Senekw/flextome/paper/flextome_paper.tex

\documentclass[11pt,a4paper]{article}
\usepackage[margin=2.2cm]{geometry}
\usepackage{lmodern}
\usepackage{graphicx}
\usepackage{booktabs}
\usepackage{amsmath}
\usepackage{siunitx}
\usepackage{microtype}
\usepackage[hidelinks]{hyperref}
\usepackage[numbers,sort&compress]{natbib}
\usepackage{caption}
\usepackage{enumitem}
\usepackage{placeins}
\renewcommand{\topfraction}{0.9}\renewcommand{\bottomfraction}{0.7}\renewcommand{\textfraction}{0.08}\renewcommand{\floatpagefraction}{0.75}
\setcounter{topnumber}{3}\setcounter{totalnumber}{5}
\usepackage{tabularx}
\usepackage{wasysym}
\captionsetup{font=small,labelfont=bf}
\sisetup{per-mode=symbol,range-phrase=--,range-units=single}
\DeclareSIUnit\rev{rev}
\graphicspath{{./figures/}}

\title{\textbf{FlexTome: a 3D-printed, flexure-pivot rocking microtome with a differential-screw feed for \SI{5}{\micro\metre} paraffin histology at a US\$61.97 bill of materials}}
\author{Design report: Engineering Mechanics / Biomedical Engineering}
\date{}

\begin{document}
\maketitle

\begin{abstract}
Histopathology is the reference standard for cancer diagnosis, but much of sub-Saharan Africa has roughly one pathologist per million people and district hospitals lack the US\$150\,000--200\,000 of equipment an essential pathology laboratory requires. The microtome that cuts 3--\SI{5}{\micro\metre} paraffin sections is one of the few items in that chain with no low-cost substitute: new manual rotary microtomes list at US\$9\,000--22\,700, and the thinnest published open-source sectioning device cuts at $\geq$\SI{50}{\micro\metre}, an order of magnitude too thick for diagnostic H\&E. We present FlexTome, a rocking-arm microtome designed to be printed on a \SI{235}{\milli\metre} desktop FDM printer and completed with hardware-store fasteners. Three design decisions make \SI{5}{\micro\metre} sectioning plausible from printed plastic: (i)~the arm pivot is a cross-strip flexure built from three \SI{0.20}{\milli\metre} spring-steel feeler-gauge strips, so the metrology loop contains no sliding or rolling joint and therefore no backlash; (ii)~the \SI{5}{\micro\metre} feed is generated by a differential screw (M8$\times$1.25 against M8$\times$1.0, \SI{0.25}{\milli\metre} per revolution) indexed by a 50-tooth printed ratchet that the arm itself advances at the top of each stroke, so the micrometre-scale motion is carried entirely by steel threads while the printed parts need only millimetre tolerances; and (iii)~the disposable blade rides on a monolithic printed parallelogram flexure stage preloaded against the screw. A crank-rocker drive gives a \SI{54}{\milli\metre} arc stroke at $\pm$\ang{12.5}. An analytic structural-loop model, calibrated by plane-stress finite-element models of the flexure stage, of the frame-nut upstand and of the frame, predicts a feed-axis loop stiffness of \SI{0.83}{\newton\per\micro\metre} (\SI{1.20}{\micro\metre\per\newton}). Two modelling lessons shaped the design: the frame model caught a \SI{0.83}{\micro\metre\per\newton} tower compliance that a beam model had missed and drove a gusset revision that cut it to \SI{0.21}{\micro\metre\per\newton}; and an external review of the first release showed that its feed-screw upstand, blade clamp and coupler did not form the load path the budget assumed (the upstand alone was \SI{7.3}{\micro\metre\per\newton}), which led to the connected, gusseted revision analysed here. A Monte-Carlo budget that treats every error as a stroke-to-stroke difference, with correlated thread-lead error, cutting-force variation, printed-ratchet error, pawl seating and thermal drift, predicts a section thickness of $5.0\pm0.7$\,\si{\micro\metre} (1~s.d.; 90\,\% interval 3.8--\SI{6.2}{\micro\metre}) at the \SI{5}{\micro\metre} setting with a thread-lead bias within $\pm0.7\,\%$, comparable to the $>\pm10\,\%$ deviation measured on commercial rotary microtomes in a 154-site survey. All structural resonances ($\geq$\SI{357}{\hertz}) lie far above the $<$\SI{9}{\hertz} cutting excitation, so chatter is not predicted. The bill of materials is US\$61.97, a $>99\,\%$ reduction relative to new list price. These are model predictions: the machine has not yet been built or measured. The design, analysis code and a validation protocol are released so that the predictions can be tested on a physical build.
\end{abstract}

\section{Introduction}
\subsection{The problem}
The cancer-diagnosis chain in low- and middle-income countries (LMICs) fails at the laboratory before it fails at the clinic. A 2016 survey of African pathology resources found population-per-pathologist ratios from 84\,000 (Mauritius) to 9.3~million (Niger), against 15\,000--20\,000 in the UK and US~\citep{Nelson2016}; the Lancet Commission on diagnostics estimates that 47\,\% of the world's population has little or no access to diagnostics~\citep{Fleming2021}; and an essential district-hospital pathology package costs US\$150\,000--200\,000 in equipment~\citep{Fleming2016}. Within that package, the microtome is the only instrument that converts a fixed, paraffin-embedded biopsy into the 3--\SI{5}{\micro\metre} section a pathologist can read. New manual rotary microtomes list at US\$22\,690 (Leica RM2125 RTS), US\$21\,548 (Sakura Accu-Cut SRM~200) and US\$8\,995 (Thermo HM~325); used units sell for US\$2\,100--7\,950 (vendor prices, October 2026).

\subsection{Why no low-cost microtome exists}
Open-source hardware has reached the microscope: the OpenFlexure microscope is printed for US\$20--200 and has been manufactured locally in Tanzania and Kenya~\citep{Collins2020}. It has not reached the microtome. The published low-cost sectioning devices cut at $\geq$\SI{50}{\micro\metre} (a hair-clipper vibrating razor~\citep{Bazer1980}), $<$\SI{100}{\micro\metre} for hand-fed plant tissue (Rapid-Tome~\citep{Thomas2023}) and \SI{250}{\micro\metre}--\SI{1}{\milli\metre} for live organoids (a US\$853 HardwareX slicer~\citep{MartinezMartin2024}). None embeds in paraffin, none uses a standard disposable microtome blade, and none has a micrometre-resolution feed. The barrier is mechanical: a \SI{5}{\micro\metre} section demands that the knife-to-specimen distance repeat to better than $\sim$\SI{1}{\micro\metre} stroke after stroke, while printed plastic parts have $\pm$0.1--\SI{0.2}{\milli\metre} dimensional scatter~\citep{Melenka2015}, creep under sustained load~\citep{Waseem2020}, a Young's modulus 60 times lower than steel~\citep{Tymrak2014}, and sliding joints printed in plastic have backlash of tens of micrometres.

\subsection{The design thesis}
Our thesis is that these limitations can be designed around rather than overcome, using three principles from precision-instrument design:
\begin{enumerate}[nosep]
\item \textbf{No sliding joints in the metrology loop.} Every joint between the blade edge and the specimen face that must repeat to $<$\SI{1}{\micro\metre} is a flexure: the arm pivot is a cross-strip flexure, the blade stage is a parallelogram flexure, and the screw-to-stage interface is a preloaded nut. Flexures have zero backlash and no stick-slip~\citep{Smith2000,Wittrick1948}.
\item \textbf{Keep the micrometre chain in steel.} The feed increment (\SI{5}{\micro\metre}) is set by the pitch difference of two standard steel threads and the tooth count of a ratchet; the printed parts only hold those steel parts in roughly the right place. The differential screw turns a \SI{0.25}{\milli\metre} pitch difference into fine motion without a precision thread~\citep{SmithChetwynd2017}.
\item \textbf{Make the structural loop short and deep.} Section-to-section thickness variation equals loop compliance $\times$ cutting-force variation; chatter is a stiffness phenomenon~\citep{Bayley1955,Warshawsky1983}. The loop is a one-piece ribbed base and a gusseted tower whose root depth (\SI{60}{\milli\metre}) was set by finite-element analysis.
\end{enumerate}
The rocking-arm kinematics themselves are not new: Horace Darwin's 1885 Cambridge rocker used a pivoted arm, screw feed and ratchet, and a modified rocker later cut sections for electron microscopy~\citep{Eaves1954}. What is new is the realisation of that kinematic in printed plastic and commodity steel at a US\$61.97 bill of materials, with an explicit, FE-checked stiffness and error budget.

\FloatBarrier
\section{Design}
\subsection{Architecture}
Figure~\ref{fig:concept} shows the assembly. The coordinate frame has $x$ along the feed (specimen~$\rightarrow$~blade), $y$ along the blade edge and $z$ vertical. Table~\ref{tab:subsystems} summarises the subsystems.

\begin{figure}[!htbp]\centering

\caption{FlexTome assembly with numbered components (frame footprint $235\times150$\,mm; overall envelope $272\times210\times202$\,mm including handwheel, feed knob and pawl rod). The specimen in a standard histology cassette (5) is carried on a \SI{125}{\milli\metre} printed arm (3) that rocks $\pm$\ang{12.5} on a cross-strip steel flexure pivot (2). The blade (6) sits on a parallelogram flexure stage (8) driven along $x$ by a differential screw (11); a striker bar on the arm (16) lifts a pawl rod (15) at the top of each stroke, advancing the 50-tooth ratchet drum (12) by 1--6 teeth (5--\SI{30}{\micro\metre}) as set by the selector shield (13). A crank-rocker (17, 18) with 608 bearings and a \SI{110}{\milli\metre} handwheel (19) drives the arm. Rendered from the parametric CAD model; Sec.~\ref{sec:mech} walks through each subsystem.}
\label{fig:concept}
\end{figure}

\begin{table}[!htbp]\small\centering
\caption{Subsystems and their role in the error budget.}
\label{tab:subsystems}
\begin{tabularx}{\linewidth}{@{}p{2.3cm}XX@{}}
\toprule
Subsystem & Implementation & Role in the error budget \\
\midrule
Frame & One printed part: $235\times150\times55$\,mm ribbed base, \SI{118}{\milli\metre} tower with a forward gusset (\SI{60}{\milli\metre} root depth tapering to \SI{32}{\milli\metre} at the pivot head), raised front deck; two M8 steel tie rods through the base & Closes the structural loop (\SI{0.21}{\micro\metre\per\newton} pivot-to-deck by FE with the base in full contact, \SI{0.35}{\micro\metre\per\newton} on two end pads; the latter is used); tie rods pre-compress the print against creep/warp and allow a split base for small printers \\
Arm pivot & Cross-strip flexure: three strips (10/20/10\,mm wide) of \SI{0.20}{\milli\metre} feeler-gauge steel, \SI{20}{\milli\metre} free length, crossing at mid-length, clamped in printed pads with M3 screws & Zero backlash; axially stiff (\SI{40}{\newton\per\micro\metre}); rotational stiffness \SI{0.27}{\newton\metre\per\radian} \\
Arm & Tapered hollow box beam $40\rightarrow30$\,mm, \SI{125}{\milli\metre} pivot-to-face; integral cassette clamp (fixed lower lip, sliding jaw, M5 thumbscrew) & Loaded axially during the cut; \SI{0.08}{\micro\metre\per\newton} \\
Drive & Crank radius \SI{13}{\milli\metre} at \SI{60}{\milli\metre} from pivot, crank centre \SI{71.2}{\milli\metre} below the arm joint; \SI{71.2}{\milli\metre} fork connecting rod running between two printed crank webs; built-up crankshaft of two \SI{8}{\milli\metre} stubs in two 608 bearings; \SI{110}{\milli\metre} spoked handwheel & Kinematics only; not in the metrology loop \\
Blade stage & Monolithic printed parallelogram: two $1.0\times44$\,mm plates (60\,mm and $2\times20$\,mm wide), platform, hanging nut tab; bolted to deck through slots ($\pm$\SI{10}{\milli\metre} coarse approach) & Guides the blade along $x$ with no sliding; pitch stiffness carries the cutting moment \\
Blade holder & Disposable low-profile blade ($80\times8\times0.25$\,mm) leaning back \ang{27} from vertical, its rear face bearing on a full-width printed back wall; \SI{1.0}{\milli\metre} steel clamp strip in front, pulled onto a \SI{0.20}{\milli\metre} blade recess by two M4 screws below the blade; \SI{2.5}{\milli\metre} edge overhang & The cutting force pushes the blade onto the back wall (not onto screw tips); clearance \ang{9.5} nominal; overhang compliance \SI{0.25}{\micro\metre\per\newton} \\
Fine feed & Differential screw: M8$\times$1.0 bolt in the stage-tab nut; its hex head sits in a printed coupler whose captured nut carries the M8$\times$1.25 rod, screwed in until the rod end bears on the bolt head (steel-on-steel axial path); the rod runs in the frame nut of a gusseted upstand $\rightarrow$ \SI{0.25}{\milli\metre\per\rev} stage motion while the screw itself translates \SI{1.25}{\milli\metre\per\rev}; both nuts sit on \SI{16}{\milli\metre} steel washers; two extension springs preload the tab onto one thread flank over the whole travel; \SI{14}{\milli\metre} long 50-tooth ratchet drum keeps the pawl engaged over the $\pm$\SI{5}{\milli\metre} screw travel; sector shield on the column selects 1--6 teeth; stage travel $\pm$\SI{1}{\milli\metre} (400 sections at \SI{5}{\micro\metre}) per reset & Sets the increment; thread-lead scatter \SI{0.18}{\micro\metre} (1~s.d.) and bias within $\pm0.7\,\%$; upstand \SI{0.19}{\micro\metre\per\newton} (FE) \\
Feed actuation & Vertical pawl rod in a printed guide, lifted $\leq$\SI{22}{\milli\metre} by a striker bar fixed to the arm during the last $\sim$\ang{6} of the upstroke; gravity/spring return & Feed occurs early in the down-stroke, when the striker releases the rod at $\theta\approx$\ang{6}, before the face reaches the edge \\
\bottomrule
\end{tabularx}
\end{table}

\subsection{Kinematics}
The crank-rocker (Fig.~\ref{fig:kin}a,b; Sec.~\ref{sec:mech}) gives $\theta=\pm$\ang{12.5}, a block-face stroke of \SI{54}{\milli\metre} and one section per handwheel turn. The machine is hand-driven, so the cutting speed is whatever rate the operator turns the wheel; all speed-dependent figures in this paper are quoted at a reference rate of 60~rpm (one section per second, the pace commonly used on manual rotary microtomes), at which the face crosses the edge at 153--\SI{174}{\milli\metre\per\second}. This is a reference point, not a measured operating speed, and the validation plan (Sec.~\ref{sec:validation}) treats speed as a variable to be set and recorded. Because the specimen travels on an arc, the face retracts \SI{3.0}{\milli\metre} from the blade at the stroke ends and the cut face is a cylinder of radius \SI{125}{\milli\metre} (sagitta \SI{0.40}{\milli\metre} over a \SI{20}{\milli\metre} block). The latter is the rocker's classical ``curved section'' property; because every stroke follows the identical arc, the curvature is cut into the block face once and the next section (the difference between two successive arcs) has uniform thickness. The effective clearance angle varies by $\pm$\ang{4.6} across a \SI{20}{\milli\metre} face; a \ang{27} blade lean (clearance \ang{9.5} at mid-face, rake \ang{45.5} with a \ang{35} blade facet) keeps it within 4.9--\ang{14.1}, inside the 3--\ang{15} range practitioners recommend (Fig.~\ref{fig:kin}c).

\begin{figure}[!htbp]\centering
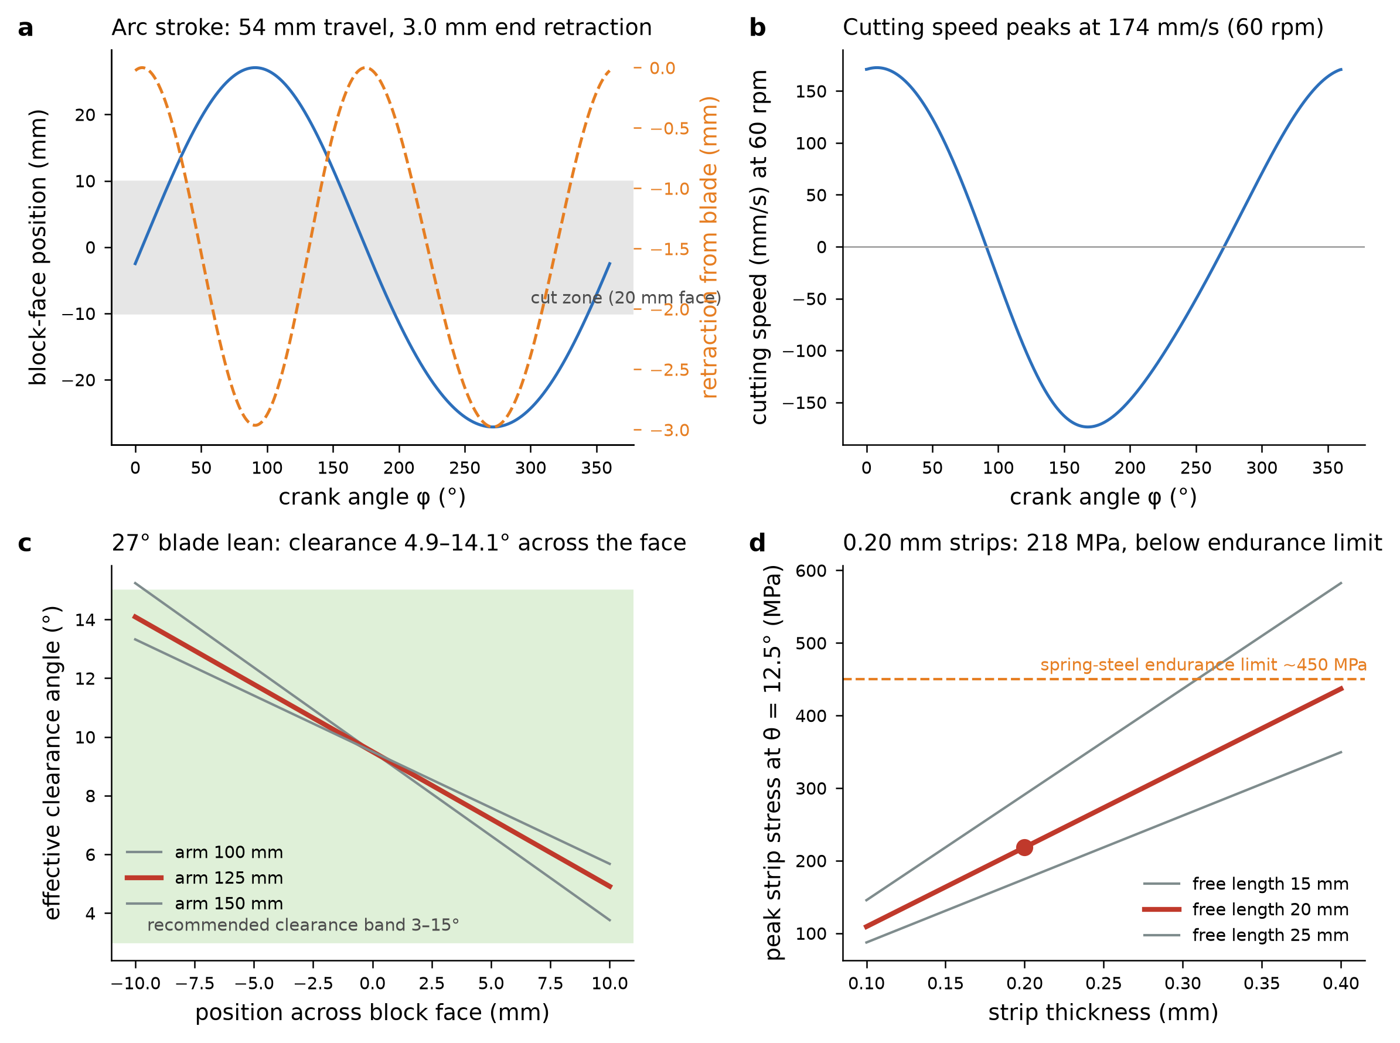
[picture p4: paper/figures/fig2_kinematics_pivot.png]

\caption{Kinematics and pivot. (a)~Face position and retraction vs crank angle. (b)~Cutting speed. (c)~Effective clearance angle across the face for three arm lengths. (d)~Peak pivot-strip bending stress vs strip thickness; the chosen $0.20\times20$\,mm strips reach \SI{218}{\mega\pascal} at full swing, below the $\sim$\SI{450}{\mega\pascal} endurance limit of hardened spring steel (feeler-gauge stock; the exact limit must be taken from the stock datasheet). Rotational stiffness is \SI{0.267}{\newton\metre\per\radian} (torque \SI{0.058}{\newton\metre} at full swing); the second-order centre shift is $\approx0.1\,L\theta^2\approx$\SI{95}{\micro\metre} at $\pm$\ang{12.5}, which is repeatable and therefore shapes the arc rather than the thickness~\citep{Wittrick1948,Haringx1949}.}
\label{fig:kin}
\end{figure}

\subsection{Feed resolution}
With pitches $p_1=\SI{1.25}{\milli\metre}$ and $p_2=\SI{1.00}{\milli\metre}$, one revolution advances the stage by $p_1-p_2=\SI{0.25}{\milli\metre}$ toward the specimen; one tooth of the 50-tooth ratchet is \SI{5.0}{\micro\metre}. The selector shield exposes $k=1\ldots6$ teeth to the pawl, giving 5, 10, 15, 20, 25 or \SI{30}{\micro\metre} settings (trimming at 20--\SI{30}{\micro\metre}, sectioning at \SI{5}{\micro\metre}). Only the \emph{difference} of the two threads matters, so ordinary rolled-thread hardware is sufficient: the budget assumes 1\,\% independent local pitch error on each thread and \SI{3}{\micro\metre} peak-to-peak periodic error per revolution.

\subsection{Blade stage design}
Figure~\ref{fig:stage}a maps plate thickness and height against bending stress at the $\pm$\SI{1}{\milli\metre} feed travel and against the $x$-stiffness that sets the preload. The chosen $1.0\times44$\,mm plates give $k_x=\SI{4.9}{\newton\per\milli\metre}$ (analytic) / \SI{4.0}{\newton\per\milli\metre} (FE), $\leq$\SI{5}{\newton} preload on the screw, \SI{5.4}{\mega\pascal} peak plate stress and a creep safety factor of 2.8 against a \SI{15}{\mega\pascal} sustained-stress limit for PLA~\citep{Waseem2020}; PETG or ASA are drop-in alternatives. In the screw-held condition the stage is a short cantilever about the tab nut; with the gusseted tab of revision~2 the FE model (Fig.~\ref{fig:feastage}) gives \SI{0.132}{\micro\metre\per\newton} at the blade edge, and this value is used in the budget. Because a symmetric parallelogram is neutral at mid-travel, its own restoring force would reverse direction across the $\pm$\SI{1}{\milli\metre} range and let the nut change thread flank; two light extension springs ($\sim$\SI{10}{\newton} total) between the tab and the upstand therefore keep the nut on the flank that the cutting force also loads.

A consequence of the differential principle that is easy to overlook: the screw body advances through the frame nut by the full \SI{1.25}{\milli\metre} per revolution while the stage moves \SI{0.25}{\milli\metre}, so over the $\pm$\SI{1}{\milli\metre} stage range the screw, coupler, ratchet and knob translate $\pm$\SI{5}{\milli\metre}. The ratchet is therefore a \SI{14}{\milli\metre} drum rather than a wheel, the \SI{13}{\milli\metre} coupler sits in a \SI{24}{\milli\metre} gap between the stage tab and the upstand, and the thickness-selector shield is mounted on the stage body, not on the screw. A boolean interference audit of the assembly (Sec.~\ref{sec:audit}) confirmed that no unintended contacts remain over the full stroke and screw travel.

\begin{figure}[!htbp]\centering
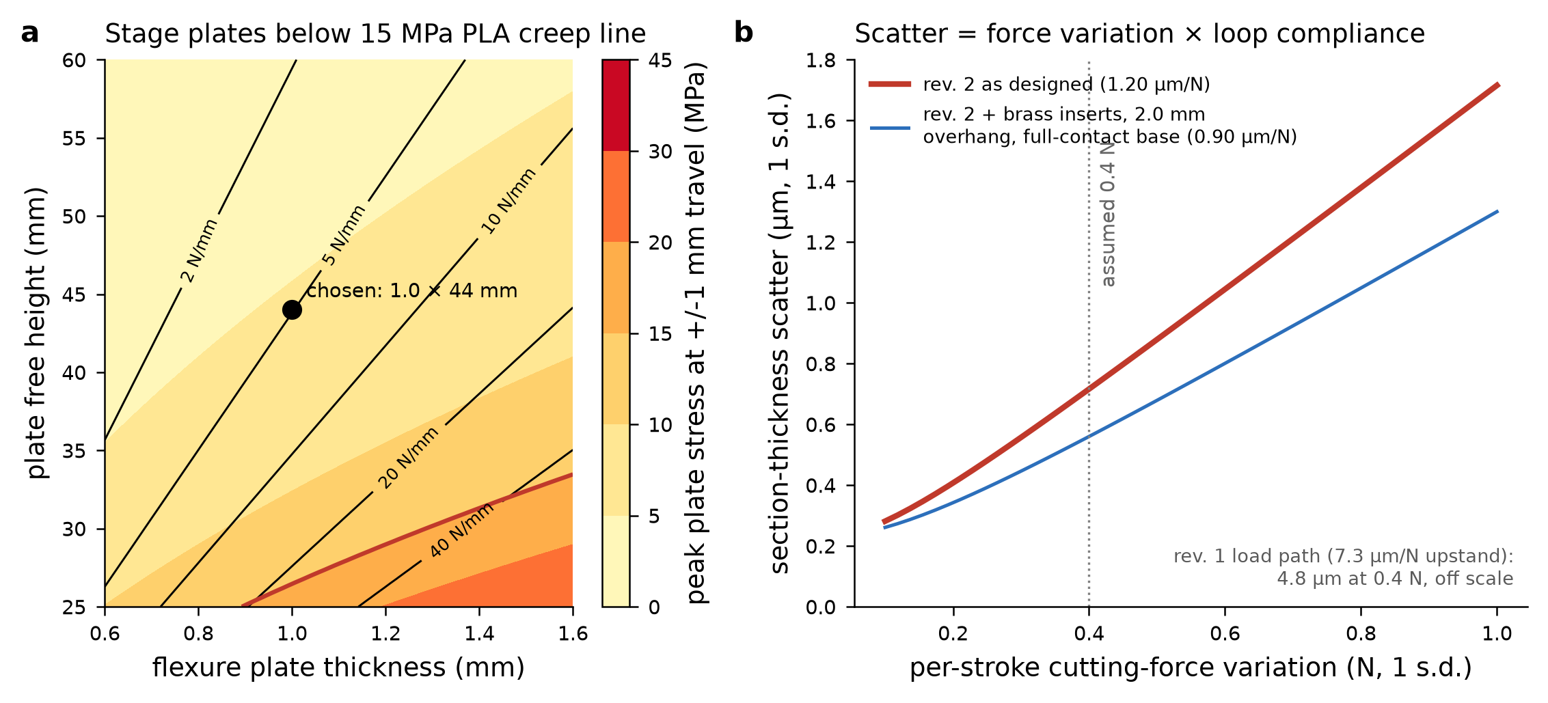
[picture p5: paper/figures/fig4_stage_design_map.png]

\caption{(a)~Design map of the flexure stage; the red contour is the \SI{15}{\mega\pascal} PLA creep line. (b)~Predicted thickness scatter vs cutting-force variation for the original slender tower and the gusseted tower; the gusset reduces scatter by $\sim$25\,\% at the assumed \SI{0.4}{\newton} force variation.}
\label{fig:stage}
\end{figure}

\begin{figure}[!htbp]\centering
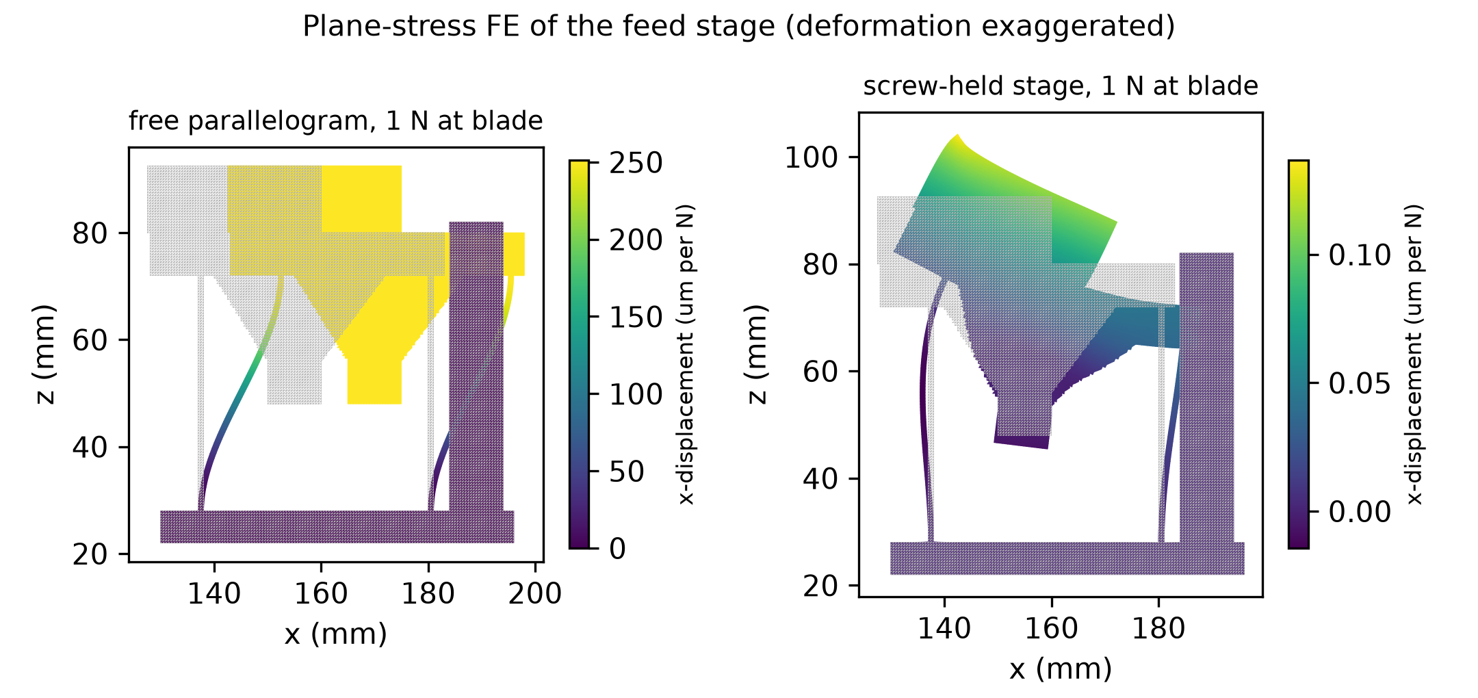
[picture p6: paper/figures/fig5_fea_stage.png]

\caption{Plane-stress finite-element model of the revision-2 stage (scikit-fem, quadratic triangles, 16\,882 elements; out-of-plane widths represented by scaling $E$ per region). Left: free stage under \SI{1}{\newton} at the blade, $k_x=\SI{3.98}{\newton\per\milli\metre}$. Right: stage held at the tab nut, compliance \SI{0.132}{\micro\metre\per\newton} at the blade.}
\label{fig:feastage}
\end{figure}

\subsection{Frame design: an FE-driven revision}
The beam model treated the tower as a $70\times70$\,mm box and the base as a plate rotating under the tower-root moment, and predicted that two M8 tie rods would triple base rigidity. A plane-stress FE model of the frame side-section (Fig.~\ref{fig:feaframe}) showed otherwise: with the tower as actually drawn (\SI{32}{\milli\metre} deep), pivot-to-deck compliance was \SI{0.83}{\micro\metre\per\newton}, essentially all tower bending, and the tie rods changed it by only 2\,\% because the ribbed base was already stiff. Adding a forward gusset (the tower root widened to \SI{60}{\milli\metre} over the first \SI{55}{\milli\metre} of height, tapering to the \SI{32}{\milli\metre} head, within the existing footprint and clear of the arm's swing) reduced the frame compliance to \SI{0.21}{\micro\metre\per\newton} with the whole underside bearing on the bench. Because a printed base may warp and bear only at its ends, the budget uses the two-end-pad support case, \SI{0.35}{\micro\metre\per\newton} (\SI{0.42}{\micro\metre\per\newton} without the tie rods, which do matter in that case). The tie rods were retained for a different reason: they pre-compress the printed base against creep and warp and allow the base to be printed in two halves on small printers.

\begin{figure}[!htbp]\centering
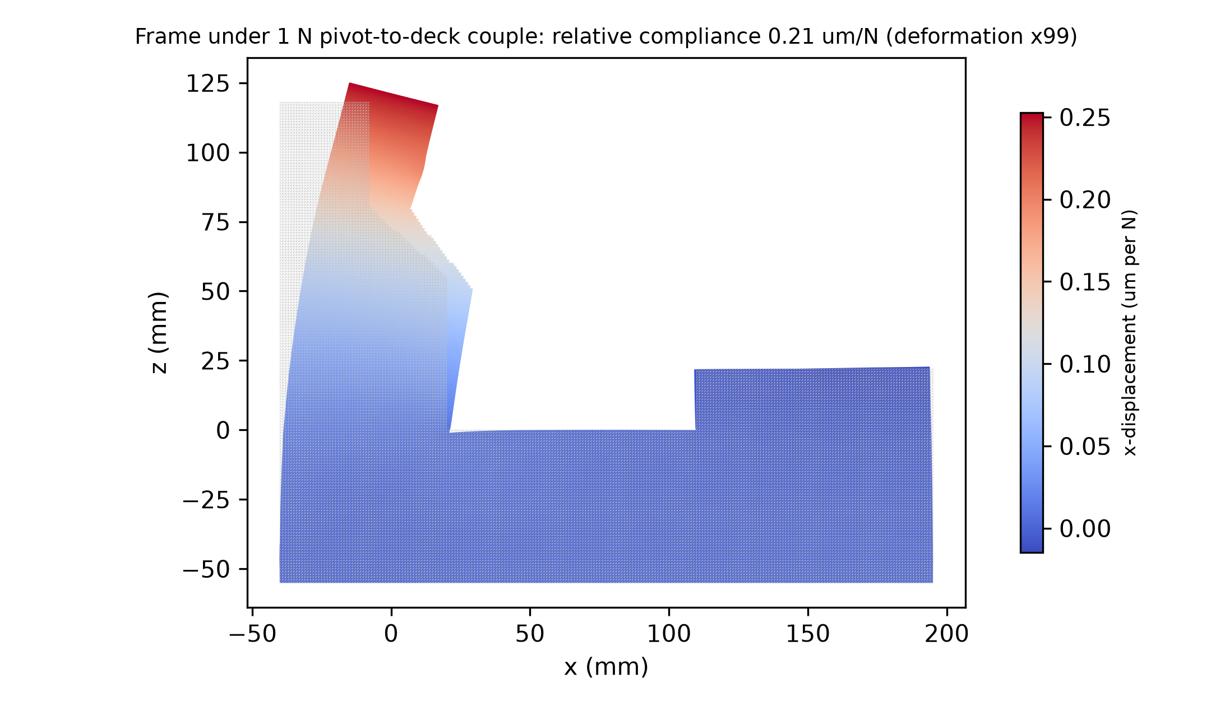
[picture p7: paper/figures/fig6_fea_frame.png]

\caption{Plane-stress FE of the gusseted frame under a self-equilibrated \SI{1}{\newton} couple between the pivot and the stage-foot clamp zone (quadratic triangles, 42\,281 elements; ribbed base represented by a 40\,\% web fraction with solid \SI{6}{\milli\metre} skins). Relative pivot-to-deck compliance \SI{0.21}{\micro\metre\per\newton} (full-contact base; \SI{0.35}{\micro\metre\per\newton} on two end pads), versus \SI{0.83}{\micro\metre\per\newton} for the original slender tower.}
\label{fig:feaframe}
\end{figure}

\input{mechanism_section}

\FloatBarrier
\subsection{Load-path corrections after external review (revision 2)}
\label{sec:rev2}
The first release of this design was reviewed independently against its own CAD and code. The review found that the structural-loop budget did not describe the load path the CAD actually contained, and the design and model were revised accordingly. The findings and corrections are listed here because they changed the headline numbers (Table~\ref{tab:rev2}).

\begin{table}[!htbp]\small\centering
\caption{External-review findings on revision 1 and the revision-2 response.}
\label{tab:rev2}
\begin{tabularx}{\linewidth}{@{}p{3.6cm}XX@{}}
\toprule
Finding (revision 1) & Why it mattered & Revision 2 \\
\midrule
Frame-nut upstand not connected to the stage foot (2\,mm gap) and only $6\times32$\,mm; omitted from the budget & A \SI{7.3}{\micro\metre\per\newton} cantilever in series with everything else: the loop would have been $\approx$\SI{8.5}{\micro\metre\per\newton} and the scatter $\approx$\SI{4.8}{\micro\metre} & Upstand continuous with the foot, \SI{10}{\milli\metre} wall, \SI{64}{\milli\metre} wide, central and side gussets: \SI{0.185}{\micro\metre\per\newton} by FE (Sec.~\ref{sec:fe}) \\
Blade held between a front pressure strip and two rear grub-screw tips & The cutting force pushes the blade \emph{away} from the strip, onto two screw points; the budget's full-width compression term did not represent this & Full-width printed back wall behind the blade carries the force; the strip clamps the blade onto a \SI{0.20}{\milli\metre} recess with two M4 screws below the blade \\
Coupler \SI{0.7}{\milli\metre} thick behind the bolt head; coarse rod not engaged with it & Unsubstantiated strength and stiffness of the only link between the two threads & \SI{13}{\milli\metre} coupler with a captured M8$\times$1.25 nut; the rod is screwed in until its end bears on the bolt head, so the axial path is steel on steel \\
Budget contained a \SI{6}{\milli\metre} ball contact that exists nowhere in the CAD; only one nut-bedding term & Fictitious and missing terms & Ball term removed; tab-nut and frame-nut bedding both included, on steel washers; coupler contact added \\
Flexure preload reverses across mid-travel & Nut could change thread flank mid-ribbon & Two extension springs preload the tab in the direction of the cutting force \\
Cutting-force variation applied as $C\,F_i$ & Thickness depends on $F_i-F_{i-1}$: the force term was $\sqrt2$ too small & Monte-Carlo rewritten so every error enters as a stroke-to-stroke difference \\
Thread pitch redrawn independently every stroke & Real lead error is fixed along the screw and correlated step to step; it produces bias as well as scatter & Lead error modelled as cumulative + periodic + local random walk per simulated screw pair; bias reported separately \\
Frame FE supported along its whole underside & A warped print bears on its ends & Two-end-pad case computed and adopted \\
Disconnected mesh shells (stage, selector strap), missing M3 holes, sealed arm cavity; audit script absent & Unprintable or unassemblable as exported; audit not reproducible & All 35 STLs now single connected shells (checked in \texttt{audit\_interference.py}, which is in the repository); insert holes added; arm cavity vented \\
No scripts for the modal, transient, fracture and BOM numbers & Not reproducible & \texttt{extra\_analysis.py} and \texttt{make\_bom.py} added \\
\bottomrule
\end{tabularx}
\end{table}

The revision lowered the deck by \SI{8}{\milli\metre} (to $z=22$\,mm) so that the taller blade holder fits above the platform while the flexure plates keep their \SI{44}{\milli\metre} free height, lowered the screw axis to $z=60$\,mm, and shifted the drum, shield and knob \SI{3}{\milli\metre} outward to clear the thicker upstand. With the connected load path the loop compliance is \SI{1.20}{\micro\metre\per\newton}; had revision~1 been built as drawn, the model predicts it would have cut $5\pm4.8$\,\si{\micro\metre}.

\FloatBarrier
\section{Analysis methods}
\paragraph{Structural-loop model.} Each element between the blade edge and the specimen face was assigned a compliance along $x$ under a unit cutting force: blade overhang bending and bearing on the back wall, the FE-calibrated stage (pitch about the tab nut), tab-nut bedding, the screw column and the rod-on-bolt-head contact, frame-nut bedding, the FE-calibrated upstand, the FE-calibrated frame (tower + base), the pivot strips in tension, the arm in compression, and the cassette clamp. Nut bedding on a \SI{16}{\milli\metre} steel washer is taken as \SI{1.5e7}{\newton\per\metre} (\SI{0.5e7}{\newton\per\metre} for a bare nut on PLA layer lines; both are allowances, not measurements). PLA $E=\SI{3.5}{\giga\pascal}$~\citep{Tymrak2014}, steel \SI{200}{\giga\pascal}.

\paragraph{Monte-Carlo thickness budget.} Section $i$ is the difference between the blade position during cut $i$ and during cut $i-1$, so every error source enters as a stroke-to-stroke difference. 200 screw pairs $\times$ 100 consecutive strokes were simulated with: a lead-error function fixed along each thread (cumulative error uniform within $\pm0.1\,\%$, per-revolution periodic error of 0.75--\SI{1.5}{\micro\metre} amplitude, and a local random walk of 0.3\,\% of pitch per step), evaluated where each nut sits at each stroke; ratchet tooth-pitch error of \SI{0.05}{\milli\metre} (1~s.d.) on the \SI{50}{\milli\metre} pitch circle; per-stroke cutting-force variation of \SI{0.4}{\newton} (1~s.d.), so that the force \emph{difference} between strokes has s.d.\ $\sqrt2\times0.4$\,N, acting through the loop compliance; thermal drift over the \SI{1}{\second} stroke interval at \SI{1}{\kelvin} per \SI{30}{\minute} room drift; and \SI{0.1}{\micro\metre} pawl seating. The cumulative lead term appears as a per-machine bias, reported separately from the scatter. The nominal cutting force (\SI{2}{\newton}) and its variation are assumptions (no absolute paraffin cutting-force measurement exists in the literature~\citep{Willis1995}), and Fig.~\ref{fig:stage}b shows the sensitivity.

\paragraph{Finite elements.}\label{sec:fe} 2-D plane-stress linear elasticity (scikit-fem, quadratic triangles) of the stage cross-section (load at the blade, foot and tab nut fixed), of the stage foot with the frame-nut upstand (load at the nut-pocket floor, foot bottom fixed; run for the revision-1 and revision-2 geometries) and of the frame side-section (self-equilibrated pivot-to-deck couple; underside fixed either fully or on two end pads), with out-of-plane widths represented by scaling $E$ per region. Verified against a cantilever benchmark (tip deflection \SI{97.3}{\milli\metre\per\newton} analytic vs 97.3 FE).

\paragraph{Modal estimates.} Lumped single-degree-of-freedom estimates for arm bending in the swing plane, stage $x$-motion and whole-loop $x$-motion.

\paragraph{Cost.} Printed-part cost from solid-modelled volume at US\$20/kg PLA (an upper bound; ribbed and infilled prints weigh less); hardware at typical online/hardware-store prices.

\FloatBarrier
\section{Results}
\subsection{Stiffness budget}
Total feed-axis compliance is \SI{1.20}{\micro\metre\per\newton} (stiffness \SI{0.83}{\newton\per\micro\metre}). The three largest terms are the frame on two end pads (\SI{0.35}{\micro\metre\per\newton}, FE), blade overhang (0.25) and the gusseted upstand (0.19, FE); the stage pitch is 0.13, the two nut seats 0.07 each, and the pivot strips only 0.02 (Fig.~\ref{fig:budget}a). With the revision-1 upstand and clamp as drawn the total would have been \SI{8.5}{\micro\metre\per\newton}.

\begin{figure}[!htbp]\centering
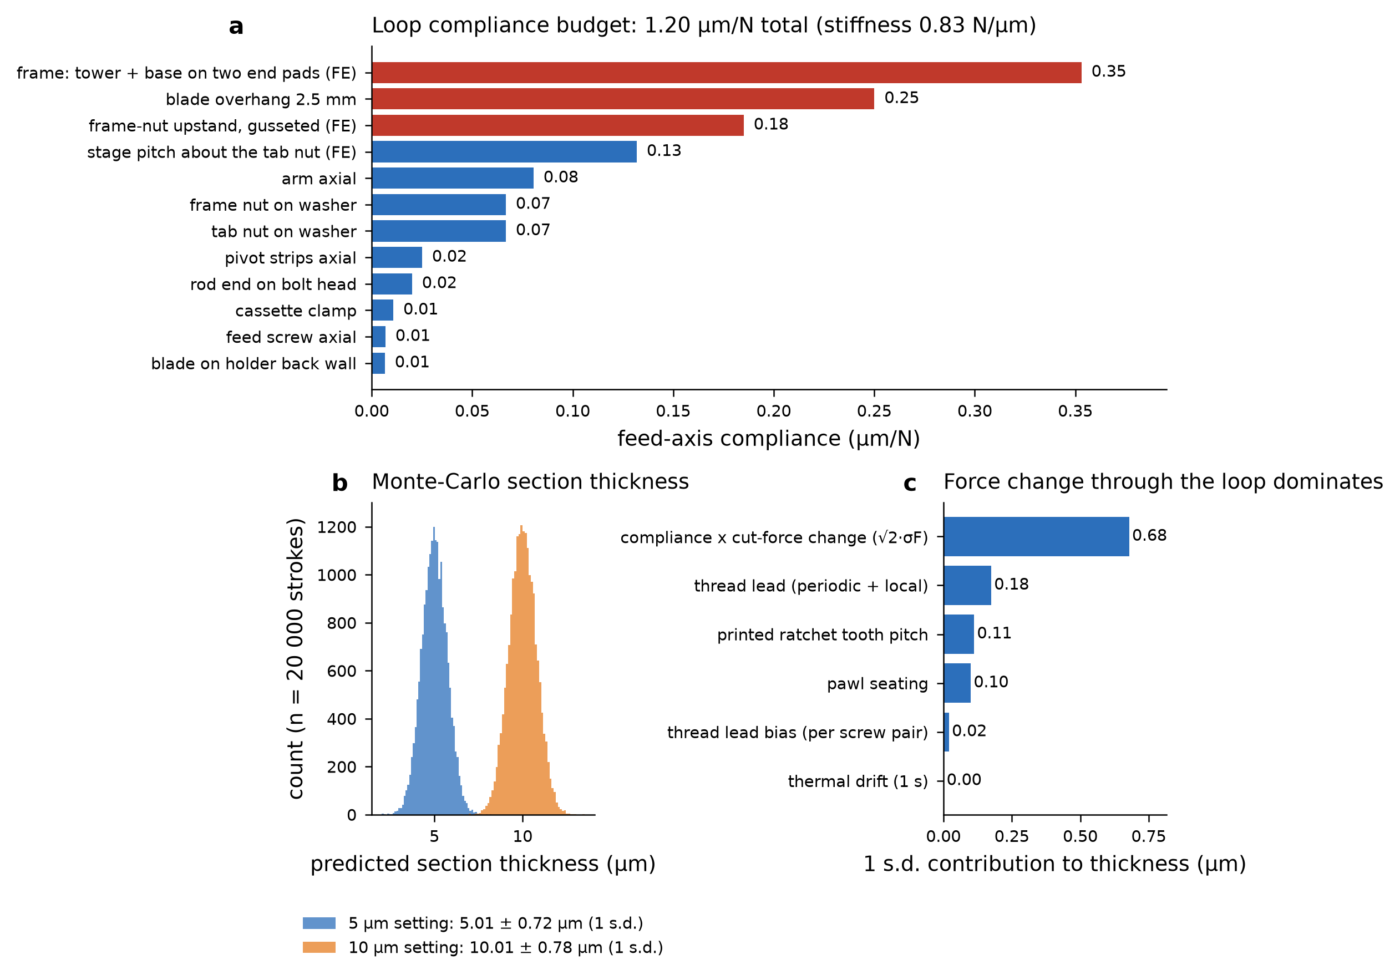
[picture p8: paper/figures/fig3_error_budget.png]

\caption{(a)~Compliance budget of the metrology loop. (b)~Monte-Carlo section thickness at the \SI{5}{\micro\metre} and \SI{10}{\micro\metre} settings ($n=20\,000$). (c)~1-s.d.\ contribution of each error source at the \SI{5}{\micro\metre} setting.}
\label{fig:budget}
\end{figure}

\subsection{Predicted section thickness}
At the \SI{5}{\micro\metre} setting the predicted section is $\mathbf{5.01\pm0.72}$\,\si{\micro\metre} (1~s.d.), 90\,\% interval 3.84--\SI{6.19}{\micro\metre}; at \SI{10}{\micro\metre}, $10.01\pm0.78$\,\si{\micro\metre}. The stroke-to-stroke change in cutting force acting through the loop compliance (\SI{0.68}{\micro\metre}) dominates; thread lead (\SI{0.18}{\micro\metre}), printed-ratchet error (0.11) and pawl seating (0.10) follow; thermal drift within a ribbon is negligible (Fig.~\ref{fig:budget}c). The cumulative lead error of the two threads adds a per-machine bias of $\pm0.7\,\%$ (90\,\% interval), which a one-time calibration against a measured ribbon removes. For context, direct measurement at 154 sites found more than two-thirds of sections from commercial rotary microtomes outside $\pm10\,\%$ of the dial setting~\citep{Fujisawa2026}; FlexTome's predicted 1-s.d.\ scatter is $\pm14\,\%$.

\subsection{Thermal behaviour}
The PLA loop expands \SI{10.6}{\micro\metre\per\kelvin}. This is irrelevant within a ribbon (strokes \SI{1}{\second} apart) but means the first sections after a temperature change or after mounting a new block will run thick or thin by several micrometres until trimmed, the same behaviour the Leica microtomy guide describes for a cold block, and handled by the same routine (trim, then section).

\subsection{Dynamics and chatter}
Estimated first modes: arm bending \SI{357}{\hertz}, whole-loop feed-axis \SI{459}{\hertz}, blade stage \SI{1.5}{\kilo\hertz}. A \SI{20}{\milli\metre} face is cut in \SI{118}{\milli\second}, so the cutting excitation is concentrated below $\sim$\SI{9}{\hertz}; no resonance-driven chatter is predicted. The rotational mode of the arm on its pivot ($\approx$\SI{4}{\hertz}) is the actuated degree of freedom and is constrained by the connecting rod.

\subsection{Cost and manufacturability}
\begin{table}[!htbp]\centering\small
\caption{Bill of materials (US\$).}
\begin{tabular}{@{}lr@{}}
\toprule
Category & Cost \\
\midrule
16 printed part types (20 pieces), \SI{1.40}{\litre} PLA (solid-modelled upper bound) & 34.57 \\
Hardware (feeler gauges, bearings, shaft, rods, nuts, washers, screws, springs) & 24.80 \\
Consumables (one blade, adhesive, grease) & 2.60 \\
\midrule
\textbf{Total} & \textbf{61.97} \\
\bottomrule
\end{tabular}
\end{table}
Against US\$8\,995--22\,690 new and US\$2\,100--7\,950 used, this is a $>99\,\%$ and $>97\,\%$ reduction respectively. The largest part (frame, $235\times150\times173$\,mm) fits an Ender-3-class \SI{235}{\milli\metre} bed (or is split at the deck step for smaller printers); all other parts fit a \SI{180}{\milli\metre} bed. No machining is required; the only cutting operations are shearing feeler-gauge strips to length and cutting threaded rod.

\subsection{Cutting-force bound, improvement levers and the entry transient}
\label{sec:levers}
Because no absolute paraffin cutting force has been published, the $2\pm0.4$\,\si{\newton} assumption was bracketed with the pressing-and-slicing fracture model~\citep{Atkins2004}: with a fracture work $R=20$--\SI{80}{\joule\per\metre\squared}, wax yield stress 1--\SI{3}{\mega\pascal}, a \ang{35} facet and friction coefficient 0.3, a $\SI{5}{\micro\metre}\times\SI{25}{\milli\metre}$ cut requires 0.6--\SI{2.4}{\newton} along the stroke and only 0.23--\SI{0.86}{\newton} along the feed axis ($\leq$\SI{1.3}{\newton} for a dulled blade with doubled friction). The feed-axis force that drives thickness error is therefore likely below the \SI{2}{\newton} assumed, and the \SI{0.4}{\newton} (1~s.d.) variation is conservative; at \SI{0.2}{\newton} the predicted scatter falls to \SI{0.41}{\micro\metre}.

Three levers remain. (i)~The blade overhang on the \emph{back-wall} side is not limited by the specimen's swept circle (that limit applies to the front strip, whose top would enter the circle by \SI{0.09}{\milli\metre} at \SI{2.0}{\milli\metre}), so the wall top can rise to \SI{2.0}{\milli\metre} below the edge with a relief chamfer for the section: $1.20\rightarrow$\SI{1.08}{\micro\metre\per\newton}, scatter $0.72\rightarrow$\SI{0.65}{\micro\metre}. (ii)~Bedding the base fully on the bench (or shimming its ends) recovers the full-contact frame value: $1.20\rightarrow$\SI{1.06}{\micro\metre\per\newton}, \SI{0.64}{\micro\metre}. (iii)~Brass inserts in place of washers under the two nuts: $1.20\rightarrow$\SI{1.17}{\micro\metre\per\newton}. All three together give \SI{0.90}{\micro\metre\per\newton} and \SI{0.56}{\micro\metre} (Fig.~\ref{fig:stage}b). Bare nuts on PLA, by contrast, would give \SI{1.47}{\micro\metre\per\newton} and \SI{0.86}{\micro\metre}.

Within a single section, the cutting force rises over the $\sim$\SI{0.5}{\milli\metre} entry chamfer of the block face in $\sim$\SI{3}{\milli\second}. Driving the \SI{459}{\hertz}, 3\,\%-damped loop with that ramp gives a 17\,\% dynamic overshoot (\SI{0.41}{\micro\metre} on a \SI{2.4}{\micro\metre} quasi-static deflection) that rings down within \SI{46}{\milli\second} of the \SI{118}{\milli\second} cut, bounding within-section thickness non-uniformity from this source to $\approx$\SI{0.4}{\micro\metre} over the first \SI{7}{\milli\metre} of the face.

\FloatBarrier
\section{Discussion}
\paragraph{What the analysis establishes.} The predicted $5.0\pm0.7$\,\si{\micro\metre} is a model result, not a measurement. Its value is that it identifies, quantitatively, what limits a printed microtome: not feed resolution (the steel differential screw delivers \SI{5}{\micro\metre} trivially) but loop stiffness against stroke-to-stroke cutting-force change, and within that, frame support, blade overhang and the frame-nut upstand. Two lessons about method stand out. The frame FE showed that a beam-theory budget built on an idealised tower section under-predicted tower compliance eight-fold and credited the tie rods with a stiffening they do not provide. The external review of revision~1 showed something more basic: a budget is only as good as its correspondence to the drawn load path, and the drawn load path had a \SI{7.3}{\micro\metre\per\newton} element the budget never contained. Checking that every element in the force path is a connected, fastened body in the CAD, and that every term in the budget is one of those bodies, is now part of the release checklist (Sec.~\ref{sec:rev2}).

\paragraph{Relation to prior art.} The Darwin rocker already combined arm, screw and ratchet; what it lacked was a bearing that a printed machine could reproduce. Replacing its hardened steel knife-edge or journal pivot with crossed feeler-gauge strips removes the one component that required a machine shop. The differential screw is a textbook element~\citep{SmithChetwynd2017} but has not previously been reported in a microtome, where it allows the \SI{5}{\micro\metre} increment to come from two hardware-store threads rather than a micrometer spindle. The parallelogram blade stage follows the OpenFlexure precedent that FDM compliant mechanisms achieve micron-scale repeatability~\citep{Sharkey2016}.

\paragraph{Limitations and risks.}
\begin{enumerate}[nosep]
\item \emph{Cutting force is assumed.} The $2\pm0.4$\,\si{\newton} figure is an engineering estimate bracketed by fracture mechanics; no measured value exists, and paraffin cutting force depends on speed, so the measurement must be made at the defined operating speed (Sec.~\ref{sec:validation}). Doubling the variation to \SI{0.8}{\newton} raises scatter to \SI{1.04}{\micro\metre}. A load-cell measurement on the build is therefore both a validation step and a contribution in its own right.
\item \emph{No specimen retraction on the return stroke.} The face passes the edge on the upstroke flush with it. Basic manual rotary microtomes without retraction are used routinely, but knife lines are possible; a 50--\SI{100}{\micro\metre} retraction cam acting on the stage is a planned addition.
\item \emph{Cylindrical block face.} The \SI{0.40}{\milli\metre} sagitta over \SI{20}{\milli\metre} is the rocker's known property; sections flatten on the water bath. Block height is limited to $\sim$\SI{25}{\milli\metre} by the clearance-angle variation.
\item \emph{PLA creep and humidity.} The stage flexure is loaded only while displaced from neutral ($\leq$\SI{5}{\newton}, \SI{5.4}{\mega\pascal}); the user returns the screw to centre after each block. PETG/ASA or 100\,\% infill at \SI{0.1}{\milli\metre} layers reduce creep further~\citep{Waseem2020}.
\item \emph{Thread backlash.} The flexure preload and the unidirectional cutting load keep the nut flanks engaged; reversing the feed requires re-trimming, as on any manual microtome.
\item \emph{Blade clamping.} A printed back wall and a \SI{1}{\milli\metre} steel clamp strip with two screws is simpler than a commercial clamp; blade seating repeatability and the flatness of the printed wall (layer lines run along the blade) must be verified.
\end{enumerate}

\paragraph{Broader impact.} A \$62 microtome does not create a pathology service; it needs embedding, staining, a microscope and, above all, a pathologist or a telepathology link. But it removes the single highest-cost mechanical item from the chain, and does so with a device that a hospital workshop or a school with a desktop printer can build and repair. Combined with the OpenFlexure microscope, it brings the entire physical chain from block to image under US\$300.

\FloatBarrier
\section{Validation plan (for the physical build)}
\label{sec:validation}
\begin{enumerate}[nosep]
\item \textbf{Print and assemble} (frame 100\,\% infill in the pivot and deck regions, \SI{0.2}{\milli\metre} layers; stage flexure 100\,\% infill, \SI{0.1}{\milli\metre} layers, plates printed vertically). Record print mass and time.
\item \textbf{Static loop stiffness.} Apply 0.5--\SI{3}{\newton} to the block face along $x$ with a hanging mass over a pulley; read displacement with a \SI{1}{\micro\metre} dial indicator at the blade edge. Target $\geq$\SI{0.8}{\newton\per\micro\metre}. Compare to the budget element by element by moving the indicator.
\item \textbf{Feed calibration.} Advance 50 teeth (one revolution) and measure $250\pm5$\,\si{\micro\metre} stage travel; repeat 10$\times$ for pitch-error scatter.
\item \textbf{Operating speed.} Define the test speed before measuring force or thickness. Record the actual handwheel rate of each operator with a reflective marker on the handwheel and a phone camera at 240\,fps (or a Hall sensor on the crank), and convert to face speed through the crank-rocker relation of Fig.~\ref{fig:mkin}c. Use three fixed rates for the bench tests: a slow motor-driven rate of 5~rpm (\SI{15}{\milli\metre\per\second} at mid-face, comparable to the low speeds used in bench measurements of paraffin cutting force), the 60~rpm reference, and the measured hand rate, whichever differs most from 60~rpm.
\item \textbf{Cutting force at the operating speed.} Mount a \SI{5}{\newton} load cell under the stage foot; record force vs crank angle over 50 strokes at each of the three speeds above. Cutting force in paraffin depends on speed (through the rate-dependent plasticity of the wax and chip friction), so the value that replaces the assumed $2\pm0.4$\,\si{\newton} in the error budget must be the one measured at the speed at which thickness is then measured; report mean force and stroke-to-stroke s.d.\ separately, since the budget uses the latter.
\item \textbf{Section thickness} (at each of the speeds in step~4, hand-driven runs timed as in step~4). (a)~Block-consumption method: dial indicator on the trimmed face before and after 100 sections at \SI{5}{\micro\metre}. (b)~Gravimetric: weigh ribbons of 20 sections of known face area (paraffin density \SI{0.90}{\gram\per\centi\metre\cubed}). (c)~Optical: measure 20 individual sections with a confocal/interference microscope if available, following~\citet{Fujisawa2026}. Report mean, s.d.\ and the fraction within $\pm10\,\%$.
\item \textbf{Section quality.} Cut \SI{5}{\micro\metre} ribbons from standard test blocks (liver, kidney, skin) on FlexTome and a commercial microtome; H\&E stain; blinded scoring (compression, chatter, knife lines, folds) by two histotechnologists.
\item \textbf{Durability.} 10\,000 strokes ($\approx$\SI{3}{\hour} at 60~rpm, motor-driven), then repeat steps 2--6 at the same speeds.
\end{enumerate}

\FloatBarrier
\section{Conclusion}
A rocking microtome whose precision-critical joints are flexures and whose micrometre feed chain is entirely steel can be built from printed PLA and hardware-store parts for US\$61.97. The FE-checked design analysis, corrected after external review of its load path, predicts $5.0\pm0.7$\,\si{\micro\metre} sections at a loop stiffness of \SI{0.83}{\newton\per\micro\metre}, with stiffness against stroke-to-stroke force change, not feed resolution, as the limiting quantity, and identifies base support, blade overhang and the frame-nut upstand as the levers for improvement. The prediction has not been tested on a physical build; that is the next step. The complete CAD, analysis code and validation protocol are released with this report so that the prediction can be tested, and the design iterated, by anyone with a desktop printer.

\section*{Data and code availability}
\texttt{flextome\_assembly.step} (full assembly), \texttt{flextome\_stl\_parts.zip} (30 component STLs + \texttt{parts.json}), \texttt{flextome\_cad.py} (parametric CadQuery source), \texttt{flextome\_design.py} (analytic model and Monte-Carlo), \texttt{fea\_stage.py}, \texttt{fea\_frame.py} (finite-element models), \texttt{make\_figures.py}, \texttt{flextome\_bom.csv}, \texttt{references.csv} and \texttt{evidence\_summary.md} (verified literature base).

\bibliographystyle{unsrtnat}
\bibliography{flextome}
\end{document}
