Senekw/flextome/figures/fig1_concept_annotated.png

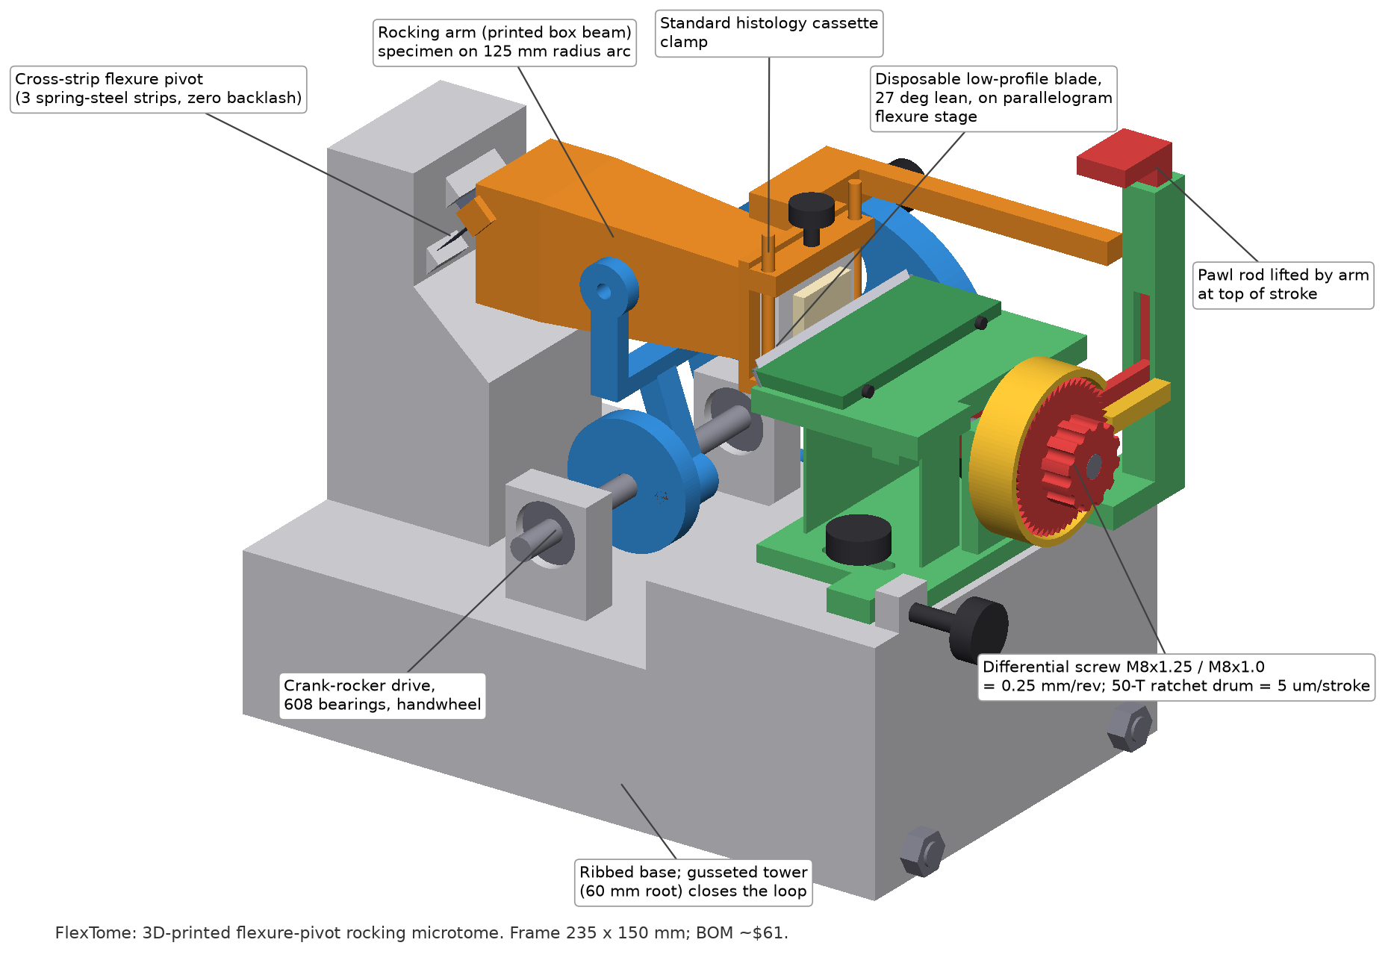
figures/fig1_concept_annotated.png
