Senekw/flextome/figures/fig_render_exploded.png

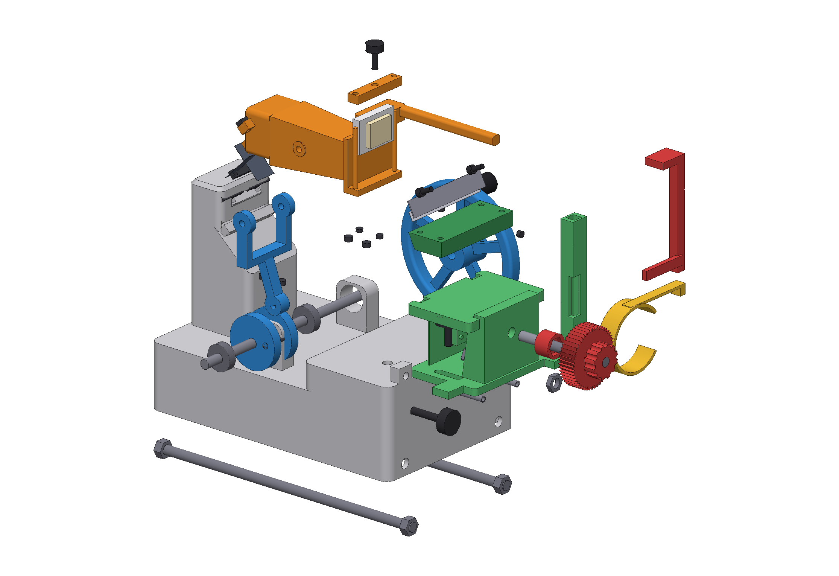
figures/fig_render_exploded.png
