Senekw/flextome/figures/fig_render_front.png

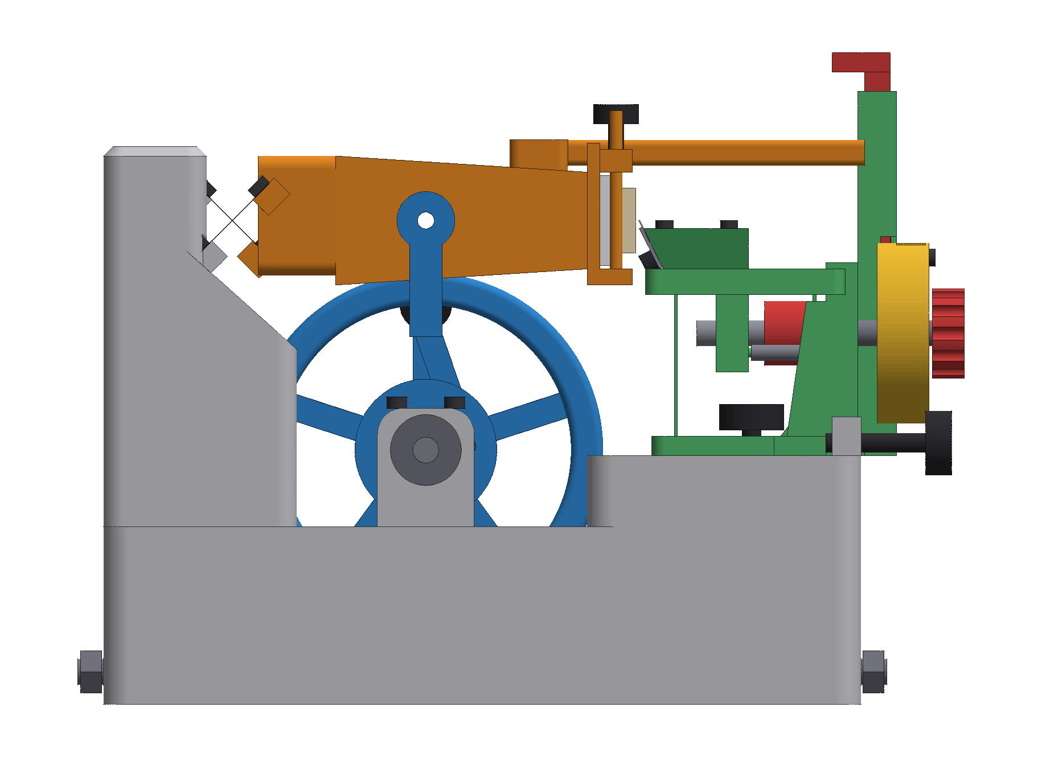
figures/fig_render_front.png
