Senekw/flextome/figures/fig_render_iso_left.png

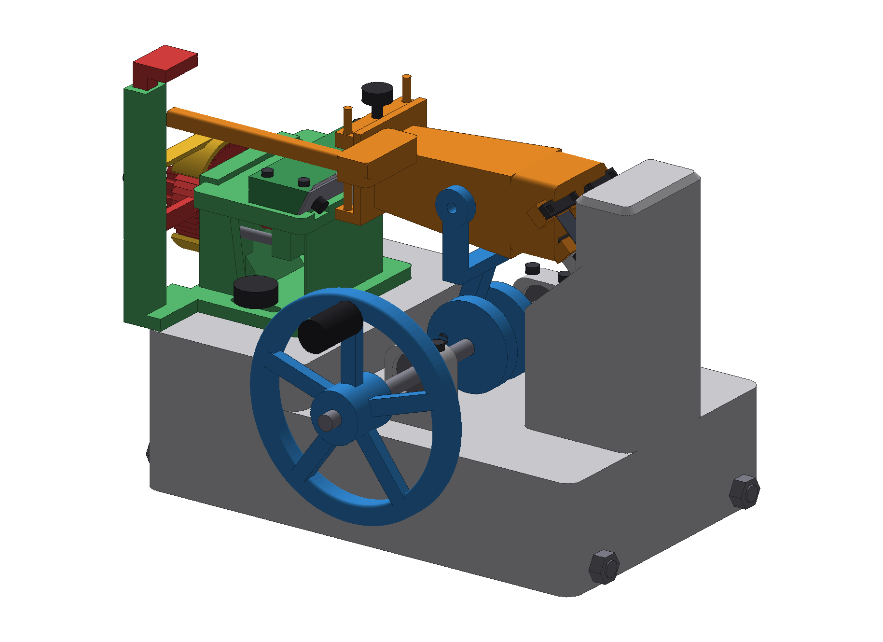
figures/fig_render_iso_left.png
