Senekw/flextome/figures/fig_render_section.png

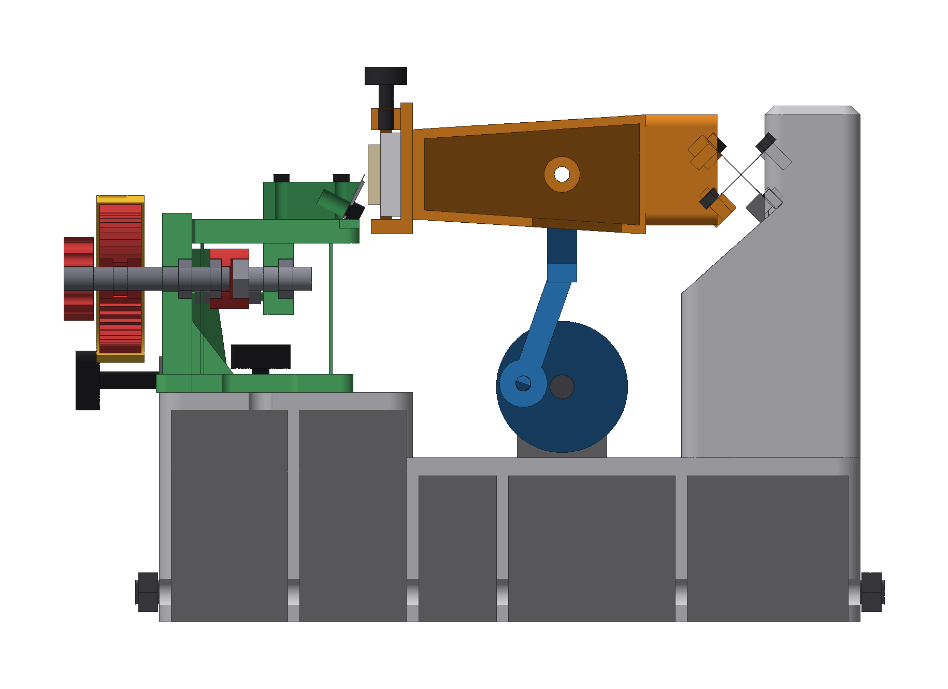
figures/fig_render_section.png
