Senekw/flextome/figures/fig_render_top.png

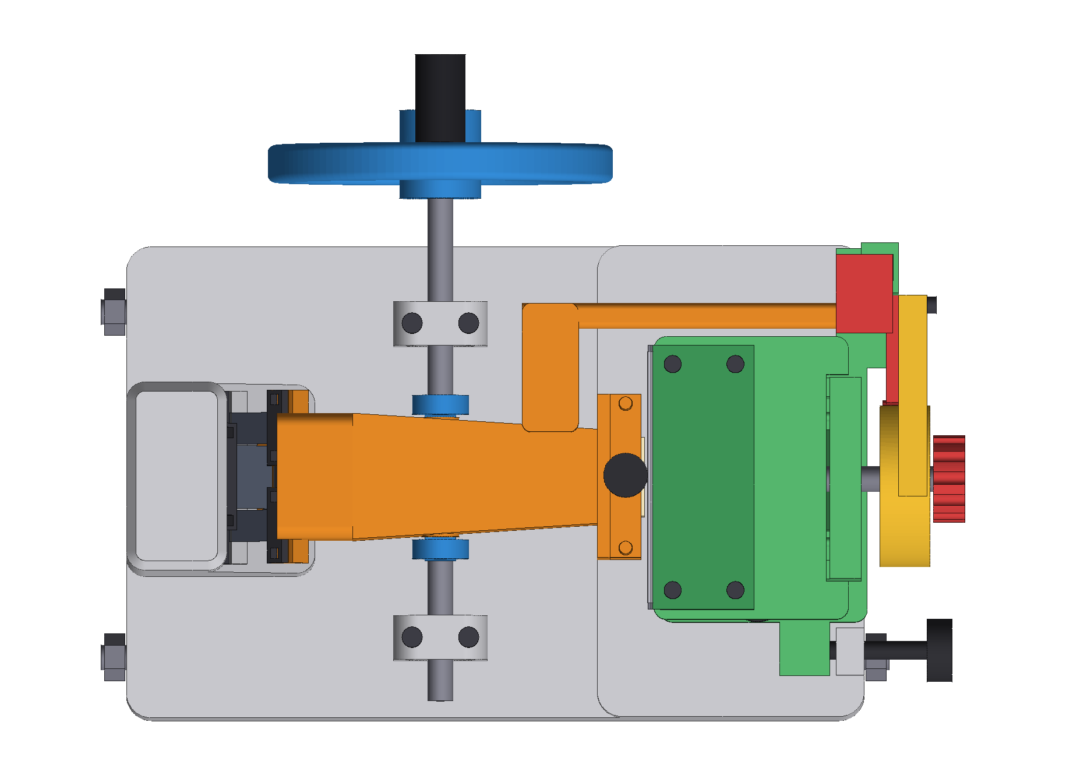
figures/fig_render_top.png
