Senekw/flextome/figures/pose_top.png

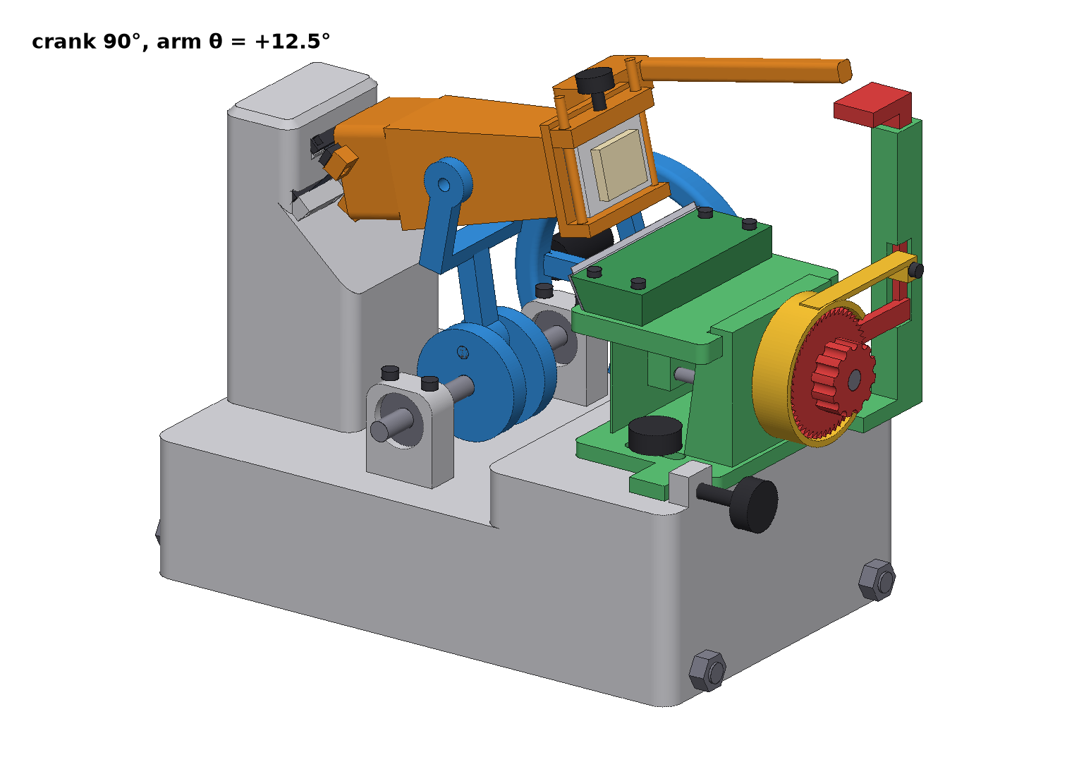
figures/pose_top.png
