Senekw/flextome/cad/step/flextome_assembly.step

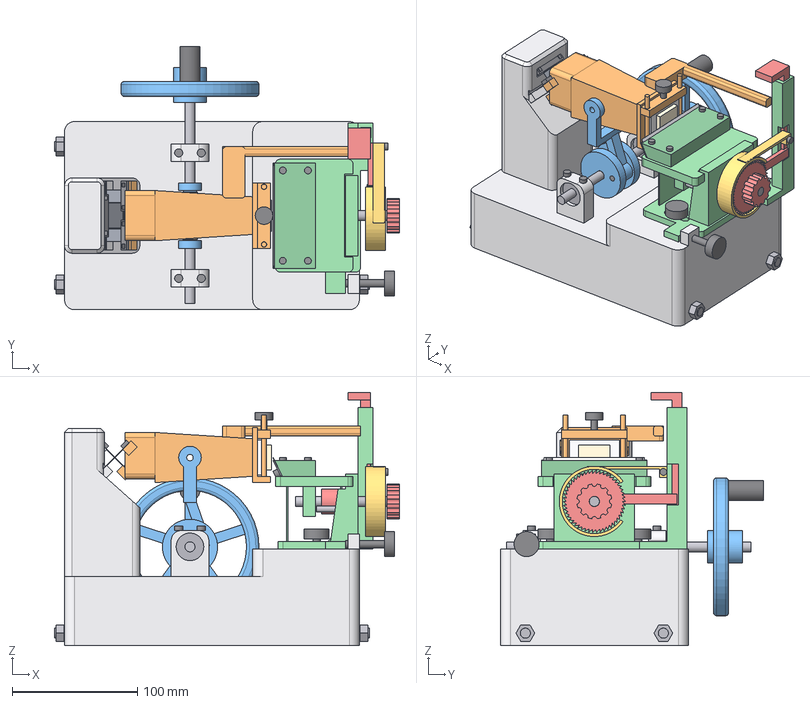
[picture p24: CAD file, 2026-10-03]
cad/step/flextome_assembly.step
275.0 x 210.0 x 202.0 mm
frame
pivot_strips_steel
pivot_clamp_plates_frame
pivot_clamp_plates_arm
arm
cassette_upper_jaw
cassette_thumbscrew
histology_cassette
paraffin_block
conrod
crankshaft
crank_disc
crank_pin
bearings_608
handwheel
handle
stage_body_flexure
blade_holder
pressure_strip_steel
blade_clamp_screws_M4
blade_low_profile
feed_screw_M8x1_25
feed_screw_M8x1_0
screw_coupler
feed_nuts_steel
coupler_nut_M8x1_25
preload_springs
ratchet_wheel_50T
thickness_selector_shield
feed_knob
pawl_rod
stage_clamp_knobs_M6
fastener_heads_M3_M4
tie_rods_M8_steel_spine
coarse_approach_screw_M6
