Senekw/flextome/cad/stl/thickness_selector_shield.stl

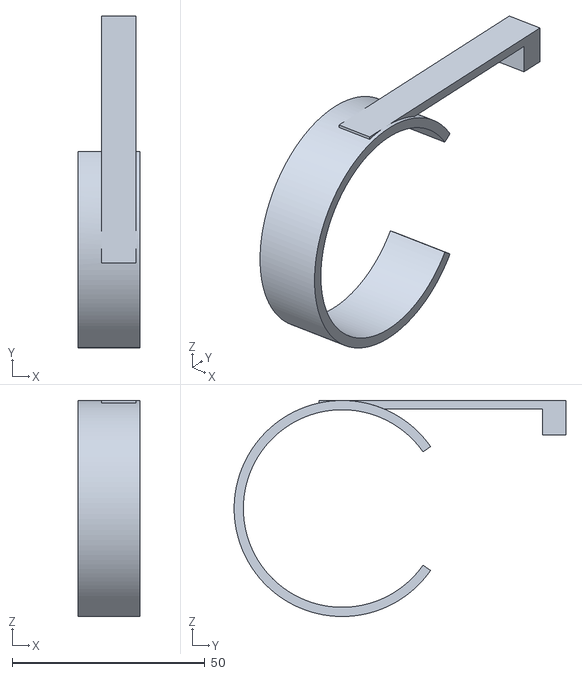
[picture p25: CAD file, 2026-10-03]
cad/stl/thickness_selector_shield.stl
16.0 x 86.0 x 56.0
