Senekw/flextome/cad/stl/fastener_heads_M3_M4.stl

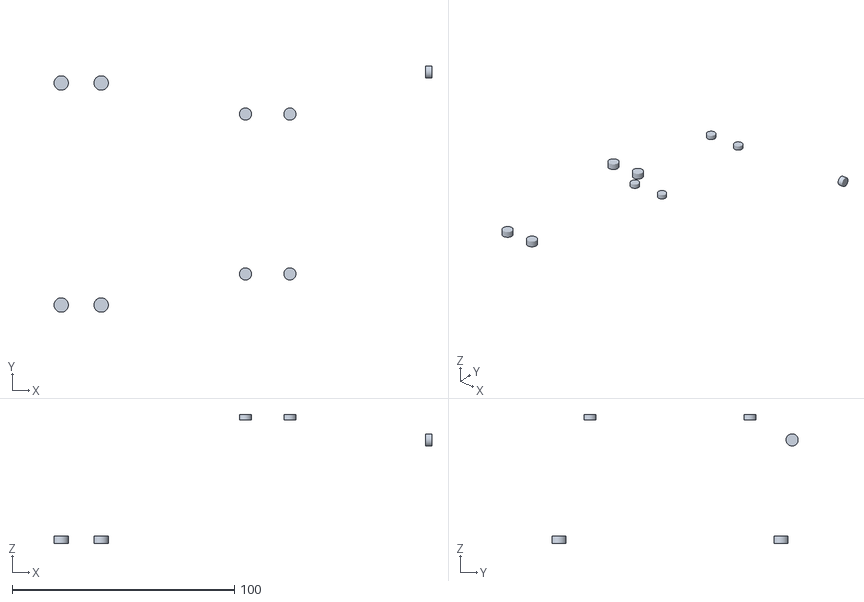
[picture p26: CAD file, 2026-10-03]
cad/stl/fastener_heads_M3_M4.stl
170.2 x 111.0 x 58.2
