Senekw/flextome/cad/stl/frame.stl

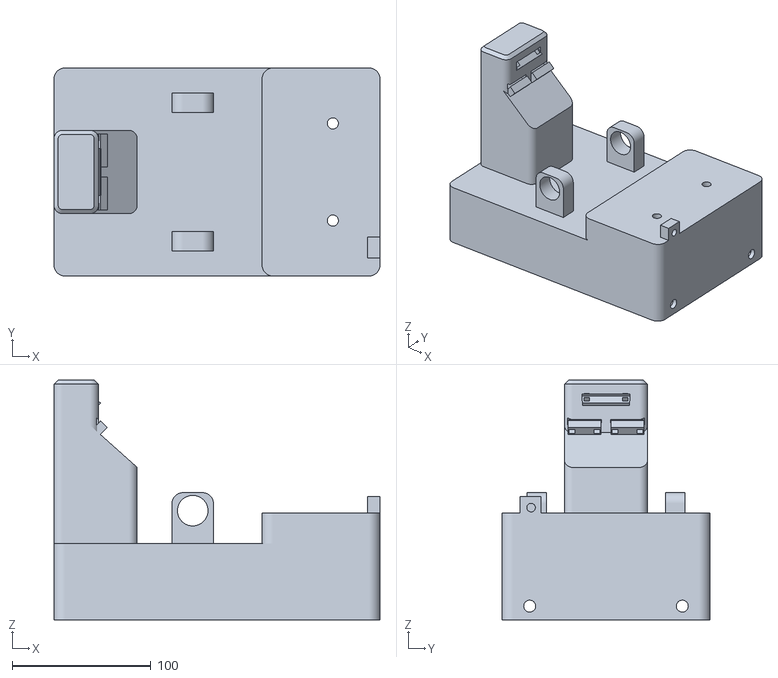
[picture p27: CAD file, 2026-10-03]
cad/stl/frame.stl
235.0 x 150.0 x 173.0
