Senekw/flextome/cad/stl/feed_nuts_steel.stl

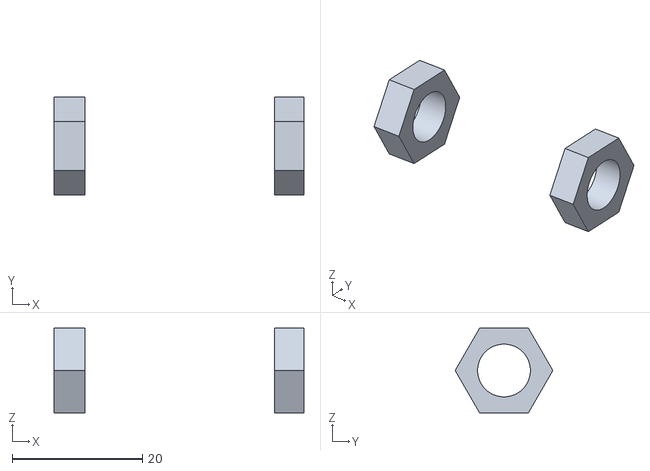
[picture p28: CAD file, 2026-10-03]
cad/stl/feed_nuts_steel.stl
38.4 x 15.0 x 13.0
