Senekw/flextome/cad/stl/pawl_rod.stl

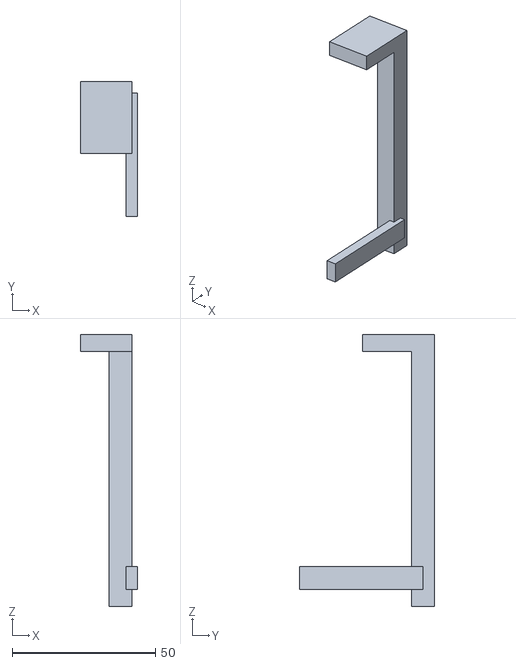
[picture p29: CAD file, 2026-10-03]
cad/stl/pawl_rod.stl
20.0 x 47.0 x 95.0
