Senekw/flextome/cad/stl/ratchet_wheel_50T.stl

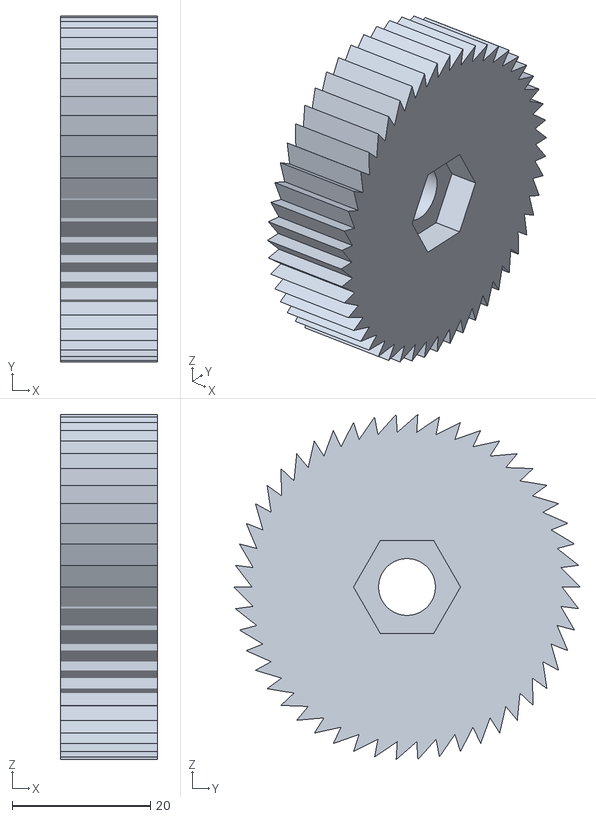
[picture p30: CAD file, 2026-10-03]
cad/stl/ratchet_wheel_50T.stl
14.0 x 50.0 x 49.9
