Senekw/flextome/cad/stl/pivot_clamp_plates_arm.stl

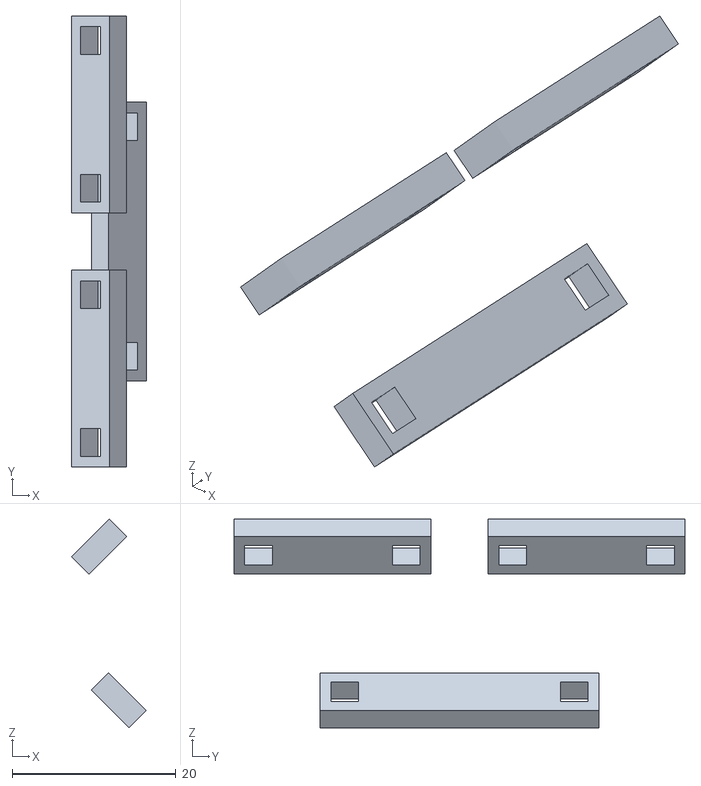
[picture p31: CAD file, 2026-10-03]
cad/stl/pivot_clamp_plates_arm.stl
9.12 x 55.0 x 25.5
