Senekw/flextome/cad/stl/stage_body_flexure.stl

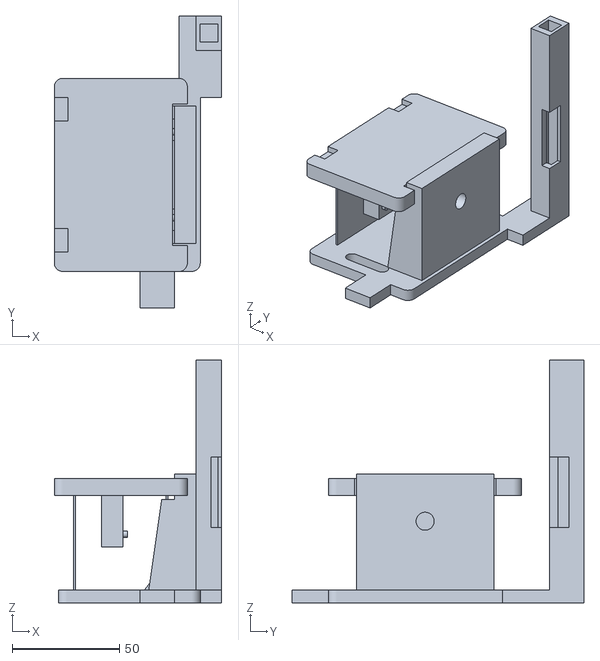
[picture p32: CAD file, 2026-10-03]
cad/stl/stage_body_flexure.stl
78.0 x 136.0 x 113.0
