Senekw/flextome/cad/stl/feed_knob.stl

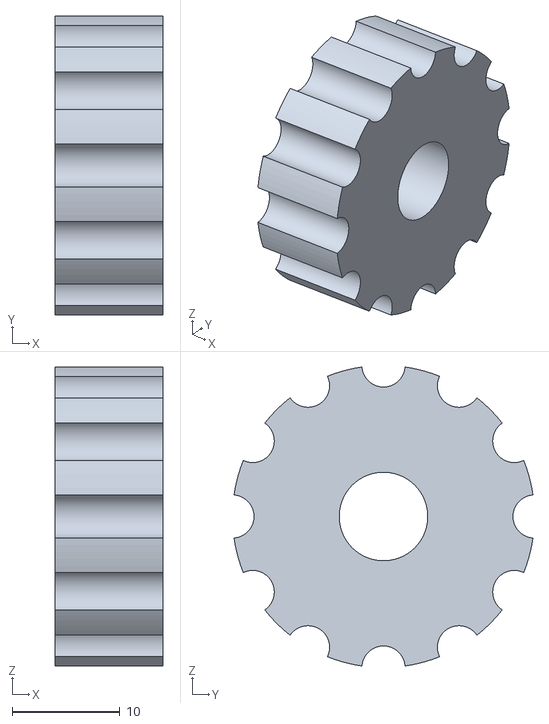
[picture p33: CAD file, 2026-10-03]
cad/stl/feed_knob.stl
10.0 x 27.7 x 27.7
