Senekw/flextome/cad/stl/stage_clamp_knobs_M6.stl

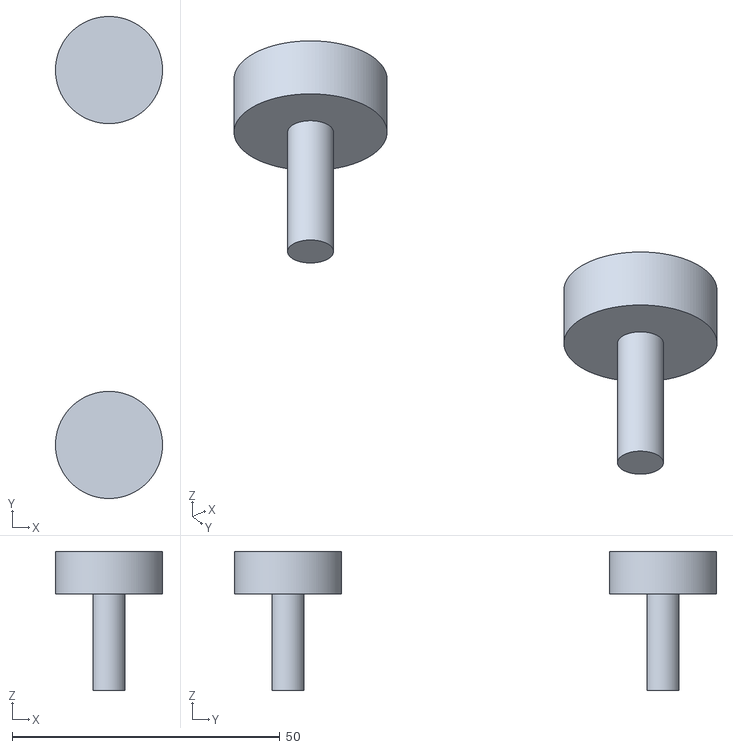
[picture p34: CAD file, 2026-10-03]
cad/stl/stage_clamp_knobs_M6.stl
20.0 x 90.0 x 26.0
