Senekw/flextome/cad/stl/arm.stl

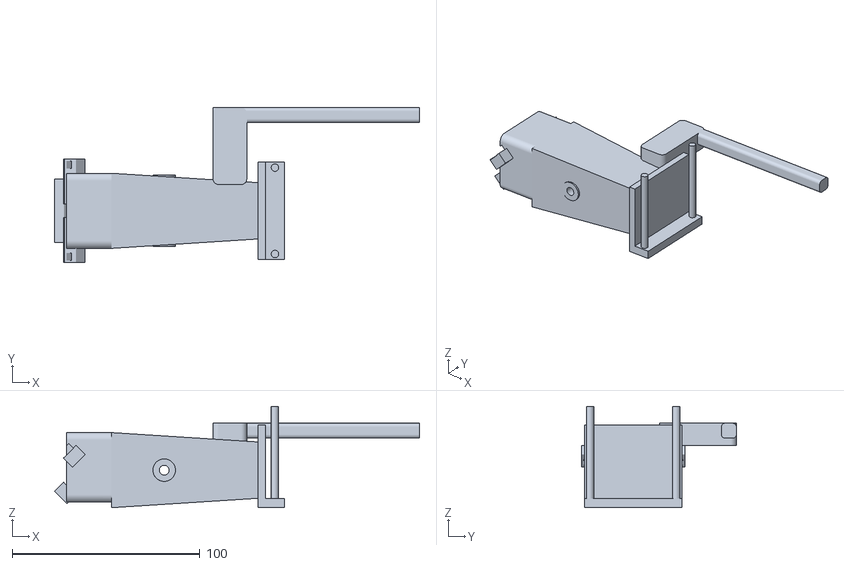
[picture p35: CAD file, 2026-10-03]
cad/stl/arm.stl
194.4 x 82.5 x 54.0
