Senekw/flextome/cad/stl/pressure_strip_steel.stl

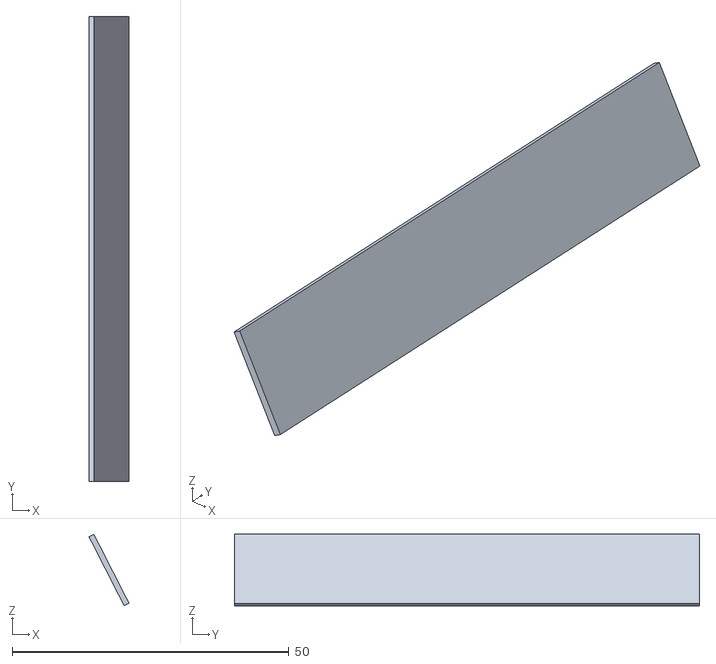
[picture p36: CAD file, 2026-10-03]
cad/stl/pressure_strip_steel.stl
7.25 x 84.0 x 12.9
