Senekw/flextome/cad/stl/preload_springs.stl

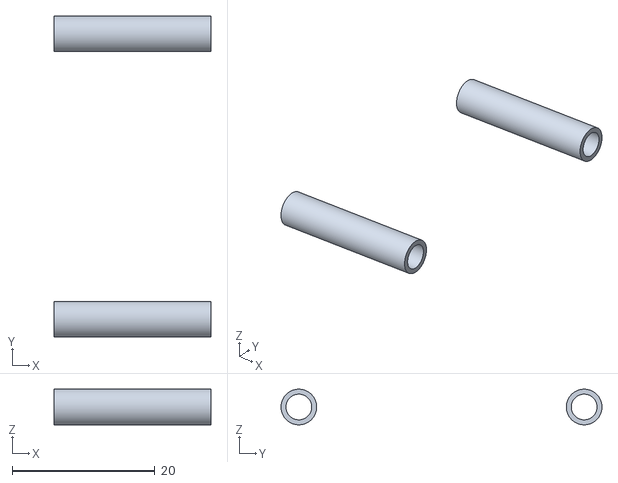
[picture p37: CAD file, 2026-10-03]
cad/stl/preload_springs.stl
22.0 x 45.0 x 5.00
