Senekw/flextome/cad/stl/pivot_strips_steel.stl

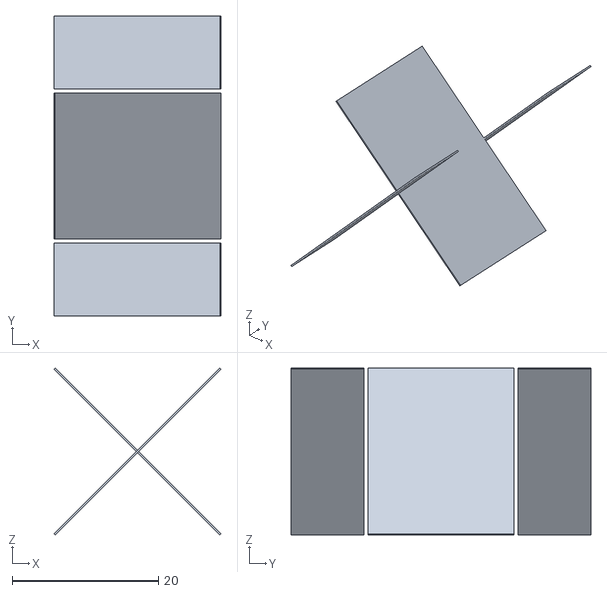
[picture p38: CAD file, 2026-10-03]
cad/stl/pivot_strips_steel.stl
22.8 x 41.0 x 22.8
