Senekw/flextome/cad/stl/blade_holder.stl

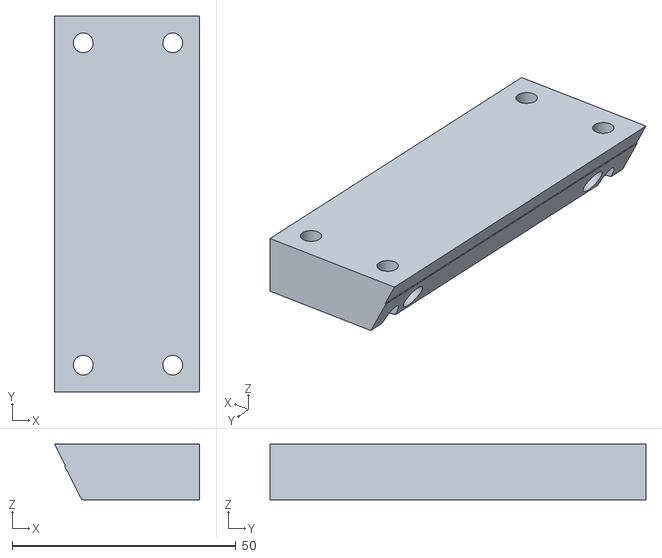
[picture p39: CAD file, 2026-10-03]
cad/stl/blade_holder.stl
32.4 x 84.0 x 12.5
