Senekw/flextome/cad/stl/blade_clamp_plate.stl

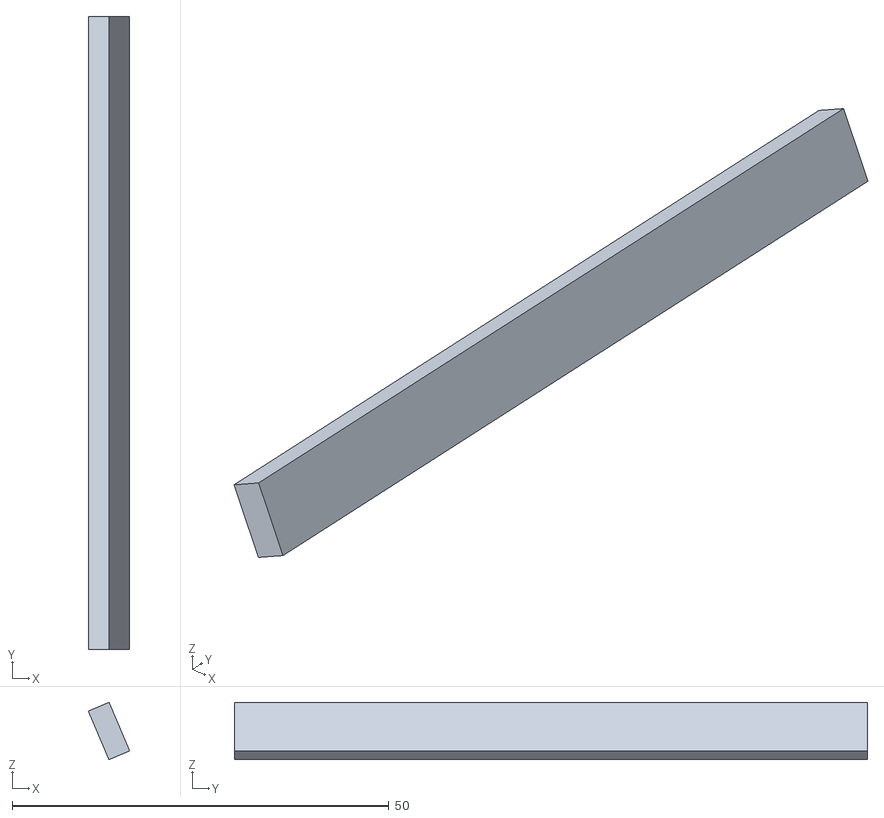
[picture p40: CAD file, 2026-10-03]
cad/stl/blade_clamp_plate.stl
5.50 x 84.0 x 7.62
