Senekw/flextome/cad/stl/crankshaft.stl

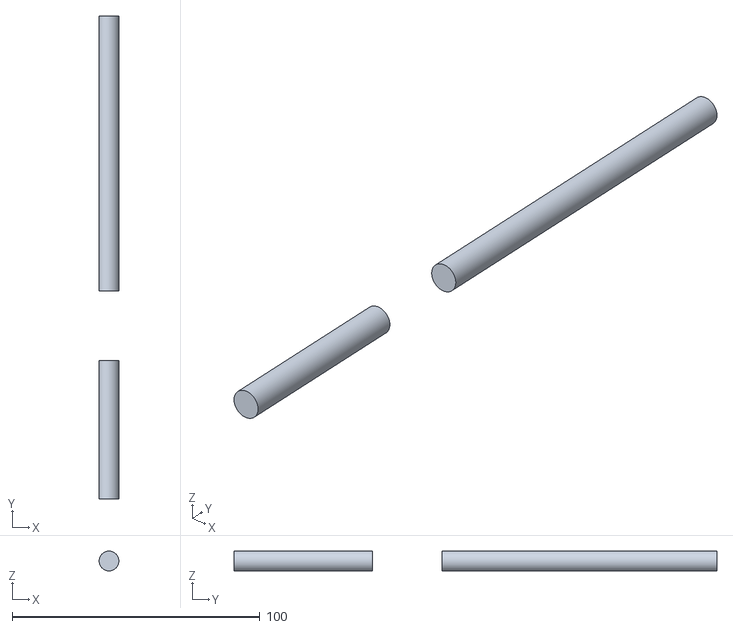
[picture p41: CAD file, 2026-10-03]
cad/stl/crankshaft.stl
8.00 x 195.0 x 8.00
