Senekw/flextome/cad/stl/crank_pin.stl

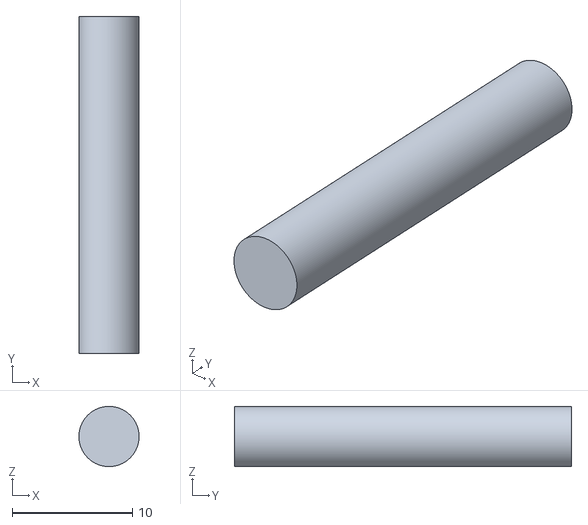
[picture p42: CAD file, 2026-10-03]
cad/stl/crank_pin.stl
5.00 x 28.0 x 5.00
