Senekw/flextome/cad/stl/paraffin_block.stl

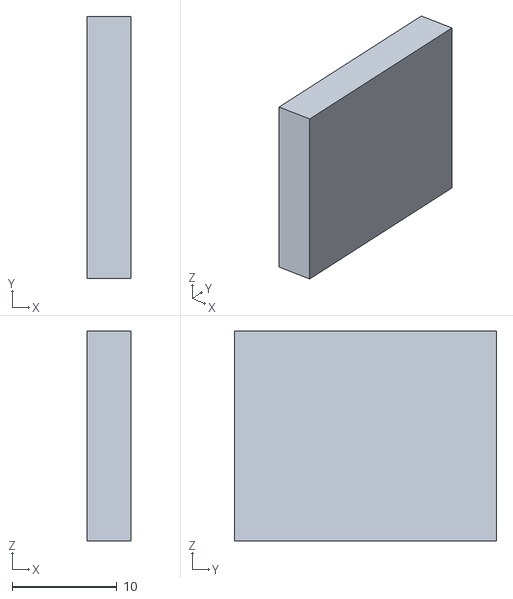
[picture p43: CAD file, 2026-10-03]
cad/stl/paraffin_block.stl
4.20 x 25.0 x 20.0
