Senekw/flextome/cad/stl/blade_low_profile.stl

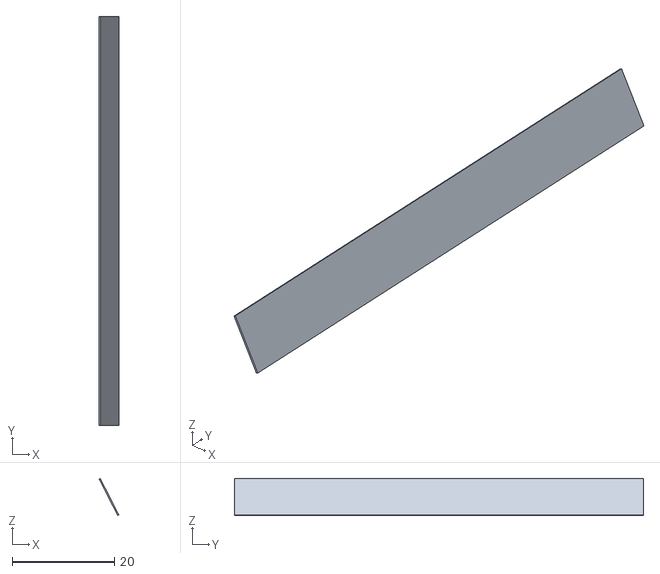
[picture p44: CAD file, 2026-10-03]
cad/stl/blade_low_profile.stl
3.85 x 80.0 x 7.24
