Senekw/flextome/cad/stl/conrod.stl

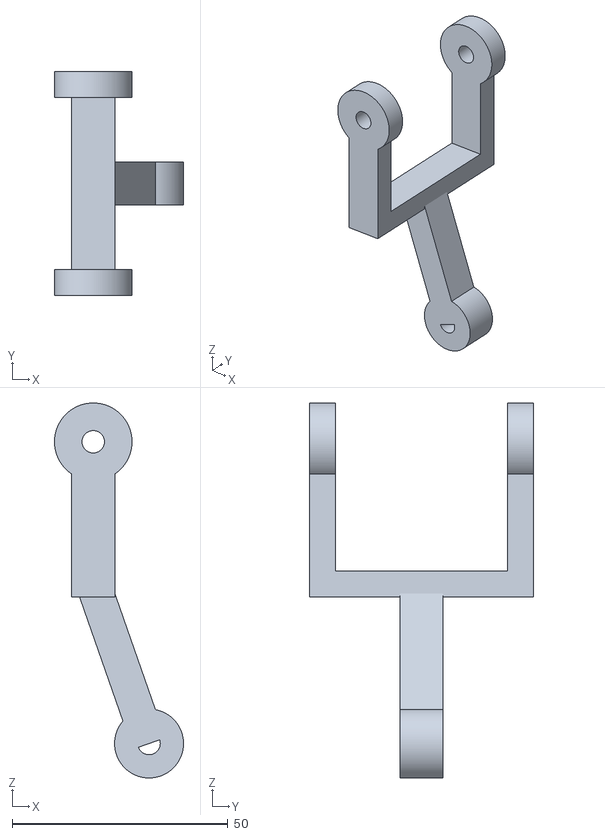
[picture p45: CAD file, 2026-10-03]
cad/stl/conrod.stl
29.9 x 52.0 x 87.0
