Senekw/flextome/cad/stl/bearings_608.stl

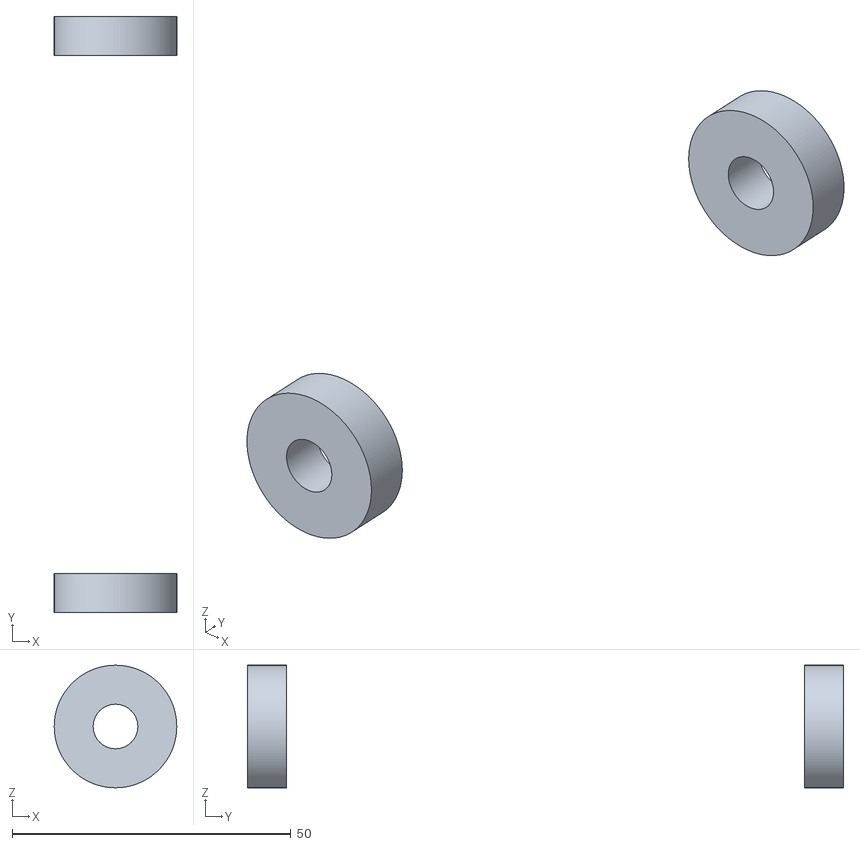
[picture p46: CAD file, 2026-10-03]
cad/stl/bearings_608.stl
22.0 x 107.0 x 22.0
