Senekw/flextome/cad/stl/handle.stl

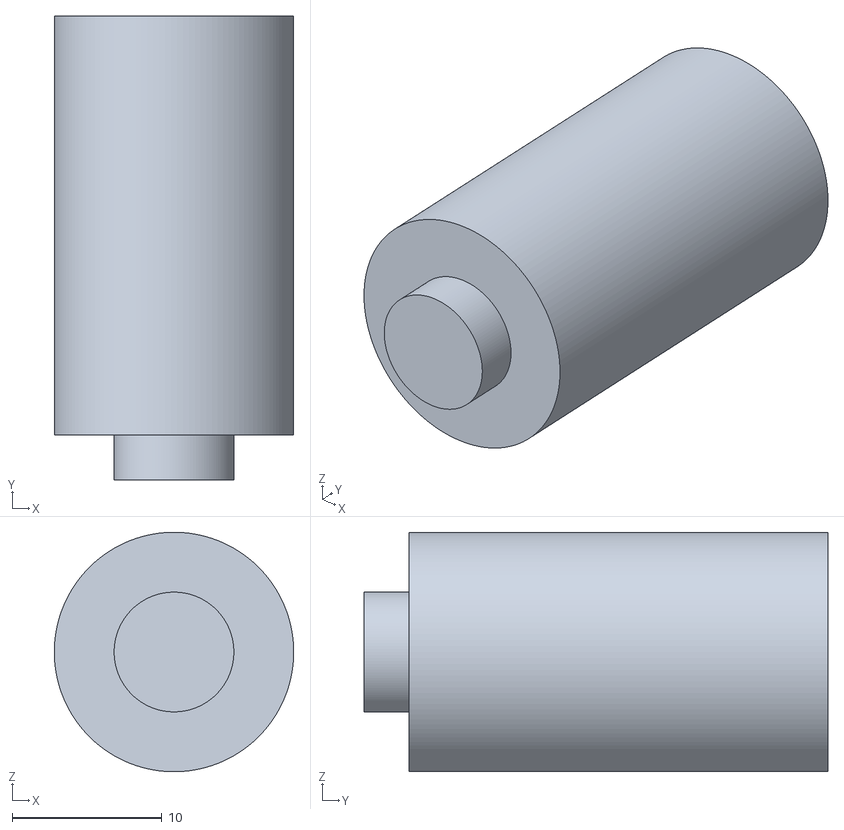
[picture p47: CAD file, 2026-10-03]
cad/stl/handle.stl
16.0 x 31.0 x 16.0
