Senekw/flextome/cad/stl/handwheel.stl

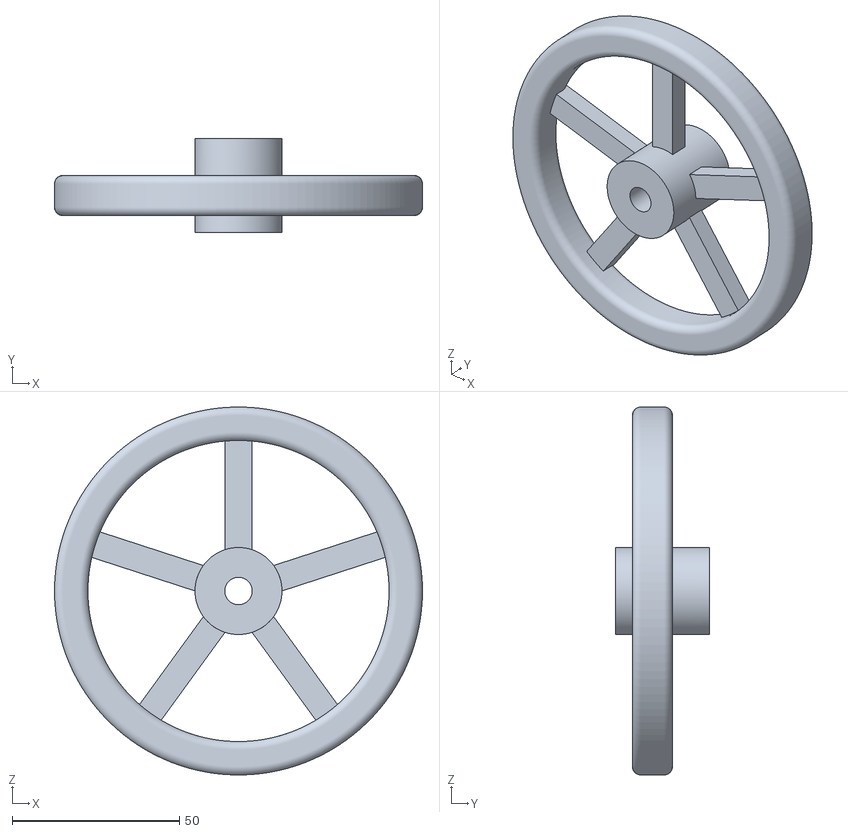
[picture p48: CAD file, 2026-10-03]
cad/stl/handwheel.stl
110.0 x 28.0 x 110.0
