Senekw/flextome/cad/stl/tie_rods_M8_steel_spine.stl

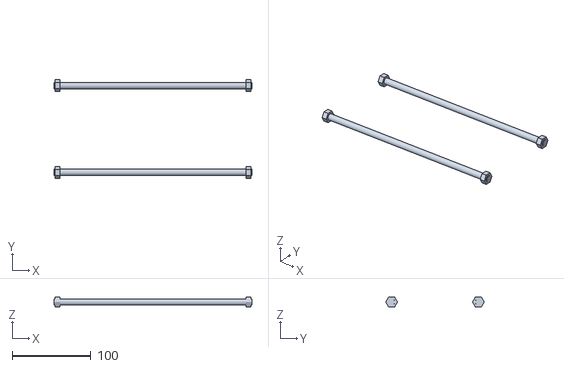
[picture p49: CAD file, 2026-10-03]
cad/stl/tie_rods_M8_steel_spine.stl
251.0 x 125.0 x 13.0
