Senekw/flextome/cad/stl/cassette_upper_jaw.stl

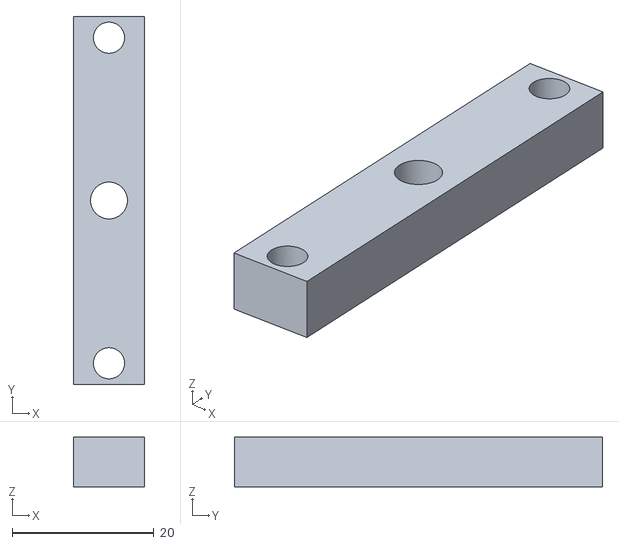
[picture p50: CAD file, 2026-10-03]
cad/stl/cassette_upper_jaw.stl
10.0 x 52.0 x 7.00
