Senekw/flextome/cad/stl/crank_disc.stl

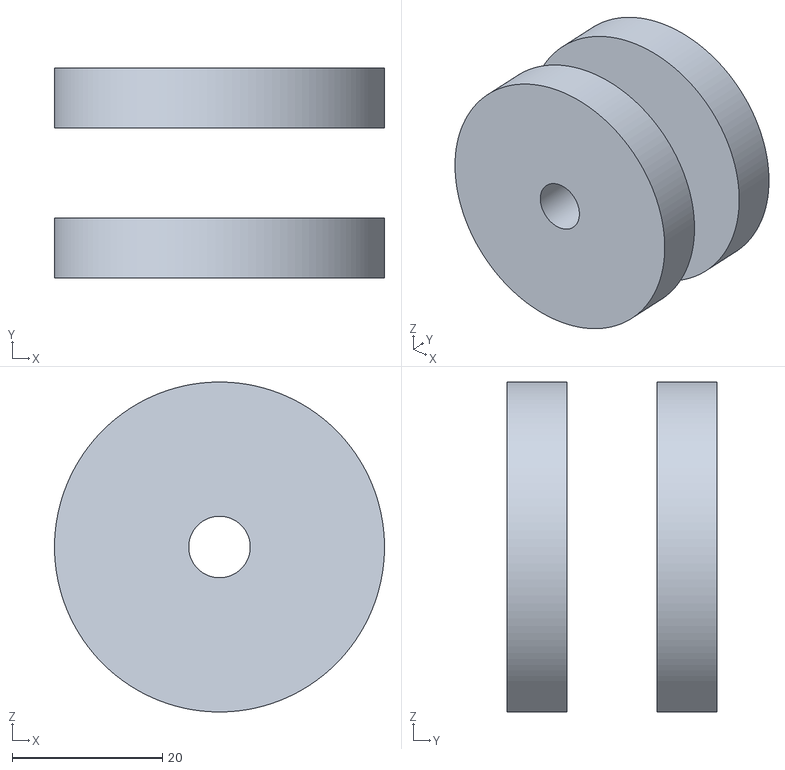
[picture p51: CAD file, 2026-10-03]
cad/stl/crank_disc.stl
44.0 x 28.0 x 44.0
