Senekw/flextome/cad/stl/histology_cassette.stl

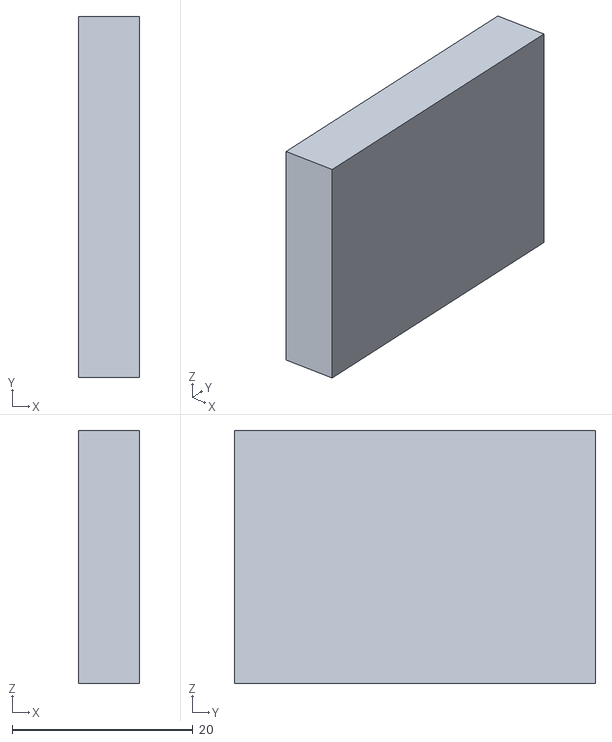
[picture p52: CAD file, 2026-10-03]
cad/stl/histology_cassette.stl
6.80 x 40.0 x 28.0
