Senekw/flextome/(list of files, cad)

Other CAD files:
cad/stl/pivot_clamp_plates_frame.stl
cad/stl/blade_clamp_screws_M4.stl
cad/stl/blade_grub_screws_M4.stl
cad/stl/cassette_thumbscrew.stl
cad/stl/coarse_approach_screw_M6.stl
cad/stl/coupler_nut_M8x1_25.stl
cad/stl/feed_screw_M8x1_0.stl
cad/stl/feed_screw_M8x1_25.stl
cad/stl/screw_coupler.stl
