Senekw/flextome/(commit log)

2026-10-03 FlexTome v1.0: parametric CAD, analysis, paper (LaTeX + PDF), figures, BOM
    [arm.stl, bearings_608.stl, blade_clamp_plate.stl, blade_grub_screws_M4.stl, blade_holder.stl, blade_low_profile.stl, cassette_thumbscrew.stl, cassette_upper_jaw.stl]
2026-10-03 Revision 2: rebuild load path after external review
    - gusseted, connected frame-nut upstand (7.3 -> 0.19 um/N by FE)
    - full-width back-wall blade holder with clamp strip and M4 screws
    - 13 mm coupler with captured nut, rod end bears on bolt head
    - washers under both nuts, preload springs, M3 insert holes, vented arm cavity
    - all 35 STLs single connected shells; audit_interference.py (collisions + connectivity) added
    - Monte-Carlo: every error as stroke-to-stroke difference, correlated thread-lead model with bias
    - fea_upstand.py, two-foot frame support case, extra_analysis.py, make_bom.py
    - paper rev 2 (22 pp), 2-page summary, callout figures with close-ups; BOM US$61.97
    [arm.stl, blade_clamp_screws_M4.stl, blade_holder.stl, coarse_approach_screw_M6.stl, coupler_nut_M8x1_25.stl, fastener_heads_M3_M4.stl, feed_knob.stl, feed_nuts_steel.stl]
